guidodehek/InterfaceS88GleisboxRPi/README.md

# InterfaceS88GleisboxRPi
Interface pcb for controlling Märklin model railway using the Gleisbox (60116) and S88 via Rocrail.
