guidodehek/InterfaceS88GleisboxRPi/documentation/MoBa-PI – Stephans Homepage.pdf

## Modellbahn, Motorrad und dann mal sehen…

# Stephans Homepage (https://s-hoppe.de/)

Seitennavigation

Home (https://s-hoppe.de/)
Modellbahn (https://s-hoppe.de/modellbahn/)
Warum Spur
N? (https://s-hoppe.de/modellbahn/warum-spur-n/)
Modellbahn
Digitalsteuerung (https://s-hoppe.de/modellbahn/digital/)
Welche
Digitalzentrale
ist die beste? (https://s-hoppe.de/welche-digitalzentrale-ist-die-beste/)

Rückmeldung (https://s-hoppe.de/modellbahn/digital/rueckmeldung/)
Stromfühler (https://s-hoppe.de/modellbahn/digital/stromfuehler/)
MoBa-PI (https://s-hoppe.de/modellbahn/digital/moba-pi/)
MoBa-Pi
Hardware (https://s-hoppe.de/modellbahn/digital/moba-pi/moba-pi-hardware/)
MoBa-Pi3
Hardware (https://s-hoppe.de/modellbahn/digital/moba-pi3-hardware/)
MoBa-Pi
Software (https://s-hoppe.de/modellbahn/digital/moba-pi/moba-pi-software/)
MoBa-Pi
Software
Quick
Guide (https://s-hoppe.de/modellbahn/digital/moba-pi/moba-pi-software-quick-guide/)

Modellbahn
Versuchsanlage (https://s-hoppe.de/modellbahn-versuchsanlage/)

# MoBa-PI

Der MoBa-Pi ist keine Erfindung von mir. Im Internet finden sich Bauanleitungen um den Raspberry Pi (https://www.raspberrypi.org/) mit SRCPD (simpe railroad commmand protocol deamon) (https://sourceforge.net/projects/srcpd/files/srcpd/) und Rocrail (http://wiki.rocrail.net/doku.php?id=start-de) zu betreiben.

Insbesondere diese Seite von Stephan Richter sollte man unbedingt lesen:

http://www.pcwelt.de/ratgeber/Modellbahnsteuerung_mit_dem_Raspberry_Pi-Guenstig_selber_machen-8937533.html (http://www.pcwelt.de/ratgeber/Modellbahnsteuerung_mit_dem_Raspberry_Pi-Guenstig_selber_machen-8937533.html)

Gegenüber einer „normalen“ Zentrale hat das Ganze den Nachteil, dass es immer etwas umständlich ist, denn man hat mindestens den Raspberry Pi (https://www.raspberrypi.org/) und einen Booster und jeweils ein Netzteil. Doch es geht praktischer mit „MoBa-Pi“! Ein weiterer Vorteil ist, dass Rocrail (http://wiki.rocrail.net/doku.php?id=start-de) auch noch auf dem Raspberry Pi (https://www.raspberrypi.org/) laufen kann und somit mit einem „Kästchen“ alles erledigt ist (es gibt einige Einschränkungen, dazu später mehr).

MoBa-Pi3 beschreibt die Verwendung des Rasperry Pi 2 oder 3. Da diese beiden Raspberrys eine 40 Polige Schnittstelle bieten, für die viele noch Kabel haben werden, da sie der alten IDE Fesplattenschinttstelle im PC entspricht, habe ich hier ein anderes Konzept

Home (https://s-hoppe.de/) | Modellbahn (https://s-hoppe.de/modellbahn/) | Motorrad fahren (https://s-hoppe.de/motorrad/) | Stephans Blog (https://s-hoppe.de/category/stephans-blog/)
Podcasts und Links (https://s-hoppe.de/podcasts-und-links/) | Über mich (https://s-hoppe.de/ueber-mich/) | Kontakt (https://s-hoppe.de/kontakt/)

Impressum, Haftungsausschluss und Datenschutzerklärung (https://s-hoppe.de/impressum-und-haftungsauschluss/)

Aufbau der
Versuchsanlag
e (https://s-hoppe.de/modellbahn-versuchsanlage/aufbau-der-versuchsanlage/)
neue
Modellbahn
Versuchsanlag
e (https://s-hoppe.de/modellbahn-versuchsanlage/versuchsanlage-neu/)

Motorrad fahren (https://s-hoppe.de/motorrad/)
Wie ich zu
meiner XJ 600 N
gekommen bin (https://s-hoppe.de/motorrad/wie-ich-zu-meiner-xj-600-n-gekommen-bin/)
Wie ich das
Motorrad auf den
ersten Winter
vorbereitet habe (https://s-hoppe.de/motorrad/wie-ich-das-motorrad-auf-den-ersten-winter-vorbereitet-habe/)
Was mir gut
geholfen hat (https://s-hoppe.de/motorrad/was-mir-gut-geholfen-hat/)
Ein Motorrad,
das mir wie
angegossen
passt! (https://s-hoppe.de/motorrad/ein-motorrad-das-mir-wie-angegossen-passt/)
Stephans Blog (https://s-hoppe.de/category/stephans-blog/)
Podcasts und
Links (https://s-hoppe.de/podcasts-und-links/)
Mein eigener
Podcast (https://s-hoppe.de/mein-eigener-podcast/)
Über mich (https://s-hoppe.de/ueber-mich/)
Kontakt (https://s-hoppe.de/kontakt/)
Impressum,
Haftungsausschlus
s und
Datenschutzerkläru
ng (https://s-hoppe.de/impressum-und-haftungsauschluss/)

umgesetzt. Ich verzichte darauf so ziemlich alles in eine Box zu packen und habe dafür ein einfach zu verwendendes und trotzdem schnell einsatzbereites System. Die verwendete SW unterscheidet sich nicht.

Um eine einfache, schnell einsatzbereite Digitalsteuerung zu haben hatte ich mir eine ROCO (http://www.roco.cc/de/home/index.html) Lokmaus 2 gekauft. Die ist aber vom Funktionsumfang her doch sehr eingeschränkt (keine langen Adressen, wenig Funktionen). Deshalb kam noch eine Multimaus (http://www.roco.cc/de/product/5215-0-0-0-0-0-0-004001/products.html) dazu (diesmal von Fleischmann, ist aber 100% die ROCO (http://www.roco.cc/de/home/index.html) Multimaus). (http://www.roco.cc/de/product/5215-0-0-0-0-0-0-004001/products.html) Da die Multimaus (http://www.roco.cc/de/product/5215-0-0-0-0-0-0-004001/products.html) bei einigen Versendern und bei Ebay (http://www.ebay.de/sch/i.html?_odkw=mutli+maus&_osacat=0&_from=R40&_nkw=multimaus&_sacat=0) als Komplettset mit Booster (Gleisbox) billiger ist als solo hatte ich nun den zweiten Booster übrig. Die Booster (http://www.ebay.de/sch/i.html?_nkw=Roco+10764&_sop=1) lassen sich aber auch so preiswert besorgen.

Was liegt also näher als den Raspberry Pi (https://www.raspberrypi.org/) mit dem Booster (http://www.ebay.de/sch/i.html?_nkw=Roco+10764&_sop=1) als Computerzentrale zu verwenden?

Die Arbeiten teilen sich, wie eigentlich immer, in die zwei Bereiche Hardware und Software auf. Zu jedem der Bereiche habe ich eine eigene Seite erstellt (Software ist noch nicht fertig), aber ich empfehle das Ganze parallel anzugehen.

-> MoBa-Pi Hardware (https://s-hoppe.de/modellbahn/digital/moba-pi/moba-pi-hardware/)

-> MoBa-Pi3 Hardware (https://s-hoppe.de/modellbahn/digital/moba-pi3-hardware/)

-> MoBa-Pi Software (für alle HW-Varianten gleich) (https://s-hoppe.de/modellbahn/digital/moba-pi/moba-pi-software/)

WordPress Theme: Smartline by ThemeZee.
