guidodehek/InterfaceS88GleisboxRPi/documentation/schematic/pican-01_orc_sch.pdf

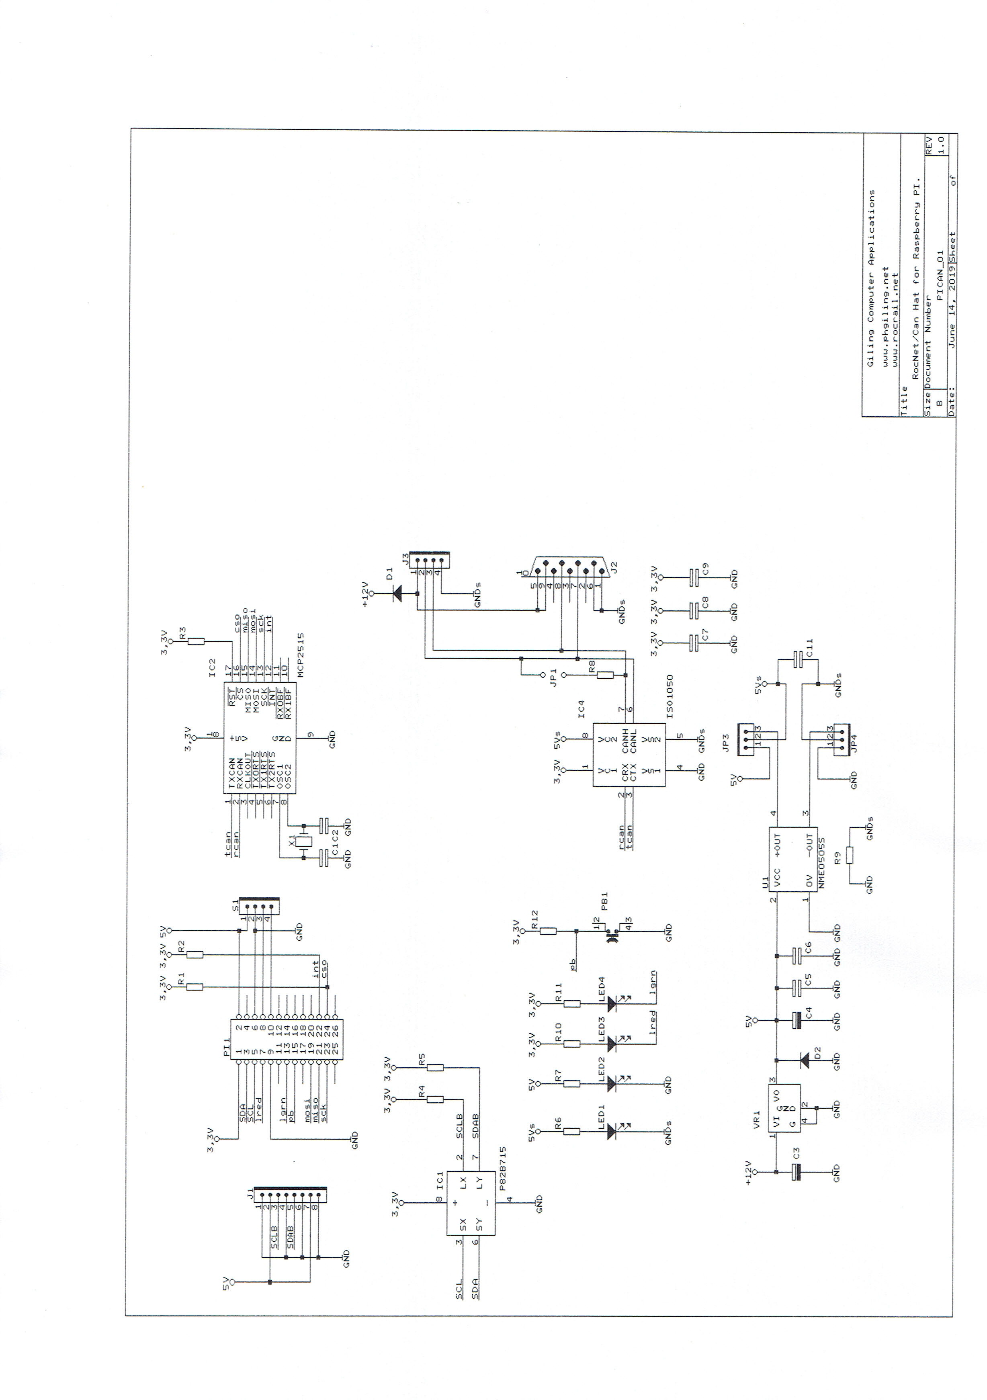
[picture p21: page 1]
