guidodehek/InterfaceS88GleisboxRPi/documentation/schematic/schematicPiGleisboxS88.png

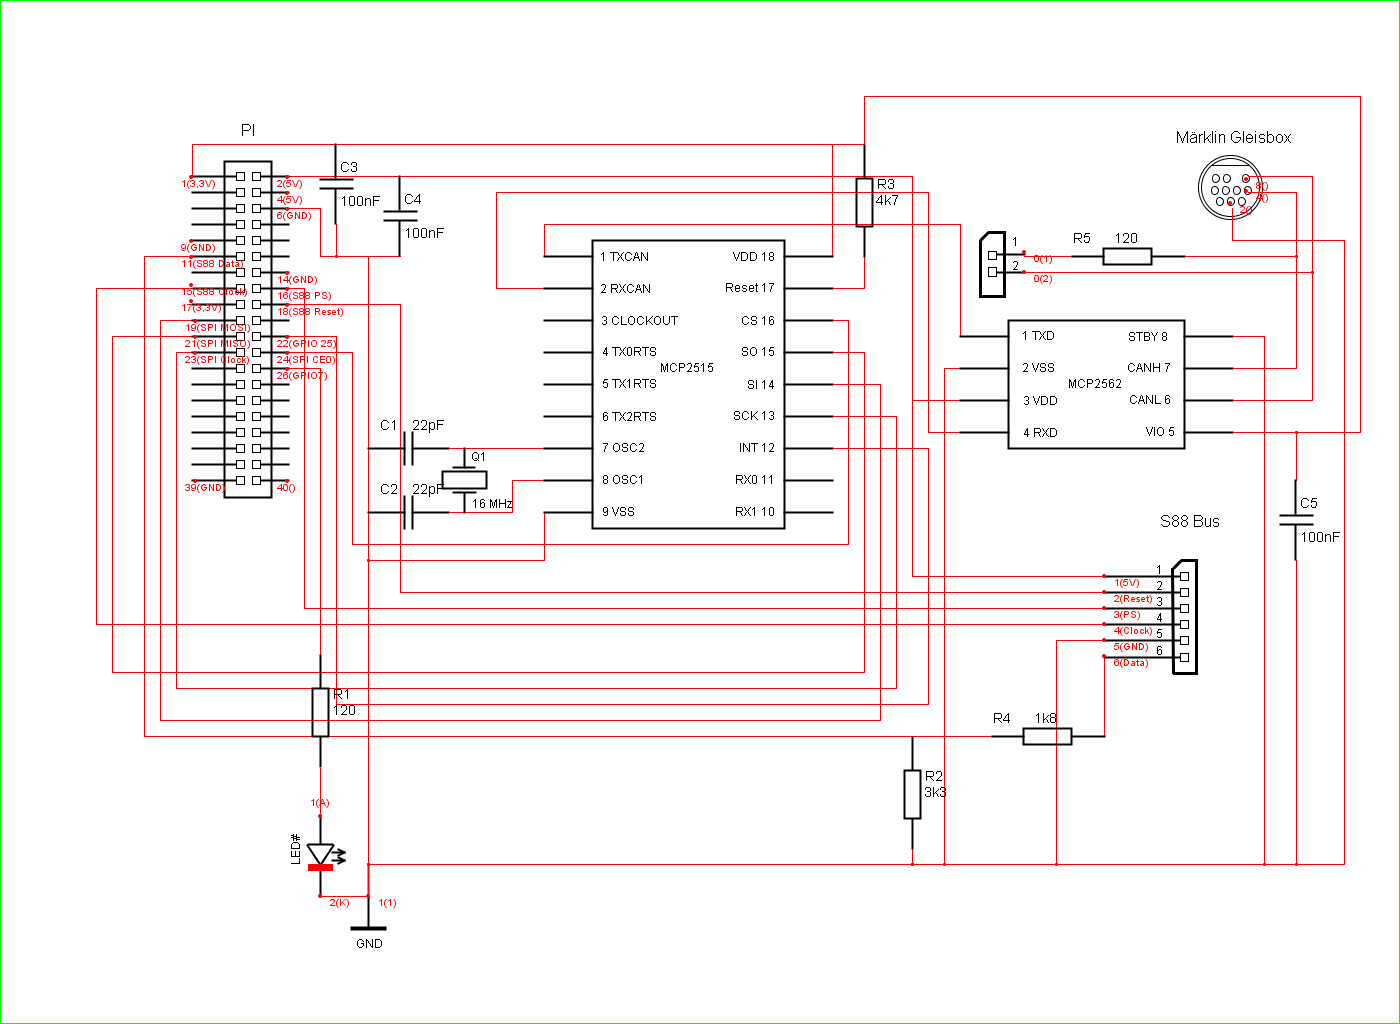
documentation/schematic/schematicPiGleisboxS88.png
