guidodehek/InterfaceS88GleisboxRPi/pcb/InterfaceS88GleisboxRPi/BillOfMaterials.xlsx

Reference | Value | Datasheet | Footprint | Qty | DNP | Available
C1,C2 | 22p | ~ | Capacitor_SMD:C_0805_2012Metric | 2 |  | 2
C3,C4,C5,C7,C8,C9,C10 | 100n | ~ | Capacitor_SMD:C_0805_2012Metric | 7 |  | 3
C6 | 10u | ~ | Capacitor_SMD:C_0805_2012Metric | 1 |  | 1
C11 | 1u | ~ | Capacitor_SMD:C_0805_2012Metric | 1 |  | 1
D1,D2 | LED | ~ | LED_SMD:LED_0603_1608Metric | 2 |  | 0
J1 | ~ |  | Connector_PinSocket_2.54mm:PinSocket_2x20_P2.54mm_Vertical | 1 |  | 0
J2 | KMDGX-10S-BS |  | CustomLib:KMDGX10SBS | 1 |  | 0
J4 | RJ45 | ~ | CustomLib:215877-1 | 1 |  | 0
J7 | PJ-102AH | ~ | Connector_BarrelJack:BarrelJack_CUI_PJ-102AH_Horizontal | 1 |  | 0
R1 | 120 | ~ | Resistor_SMD:R_0805_2012Metric | 1 |  | 0
R2,R3,R4 | 4k7 | ~ | Resistor_SMD:R_0805_2012Metric | 3 |  | 3
R5 | 330 | ~ | Resistor_SMD:R_0805_2012Metric | 1 |  | 1
R6 | 390 | ~ | Resistor_SMD:R_0805_2012Metric | 1 |  | 1
R7,R11,R13 | 270 | ~ | Resistor_SMD:R_0805_2012Metric | 3 |  | 0
R8,R12,R14 | 1k5 | ~ | Resistor_SMD:R_0805_2012Metric | 3 |  | 3
R9 | 680 | ~ | Resistor_SMD:R_0805_2012Metric | 1 |  | 1
R10 | 220 | ~ | Resistor_SMD:R_0805_2012Metric | 1 |  | 1
R15,R16 | 1k | ~ | Resistor_SMD:R_0805_2012Metric | 2 |  | 0
R17 | 0 | ~ | Resistor_SMD:R_0805_2012Metric | 1 |  | 0
SW1 | SW_Push | ~ | Button_Switch_THT:SW_PUSH_6mm | 1 |  | 0
U1 | MCP2515-xSO | http://ww1.microchip.com/downloads/en/DeviceDoc/21801e.pdf | Package_SO:SOIC-18W_7.5x11.6mm_P1.27mm | 1 |  | 1
U2 | ISO1050DUB | http://www.ti.com/lit/ds/symlink/iso1050.pdf | Package_SO:SOP-8_6.62x9.15mm_P2.54mm | 1 |  | 0
U3 | NME0505SC | https://power.murata.com/datasheet?/data/power/ncl/kdc_nme.pdf | CustomLib:Murata-NME0505SC-0-0-0 | 1 |  | 0
U4 | LM317_SOT-223 | http://www.ti.com/lit/ds/symlink/lm317.pdf | Package_TO_SOT_SMD:SOT-223-3_TabPin2 | 1 |  | 0
U5,U6,U7,U8 | 6N137 | https://docs.broadcom.com/docs/AV02-0940EN | Package_DIP:DIP-8_W7.62mm | 4 |  | 0
Y1 | 16Mhz | ~ | Crystal:Crystal_HC50_Vertical | 1 |  | 0
