guidodehek/InterfaceS88GleisboxRPi/pcb/InterfaceS88GleisboxRPi/KicadLib/IC_Murata_NME0505SC/eec.models/Murata_-_NME0505SC.step

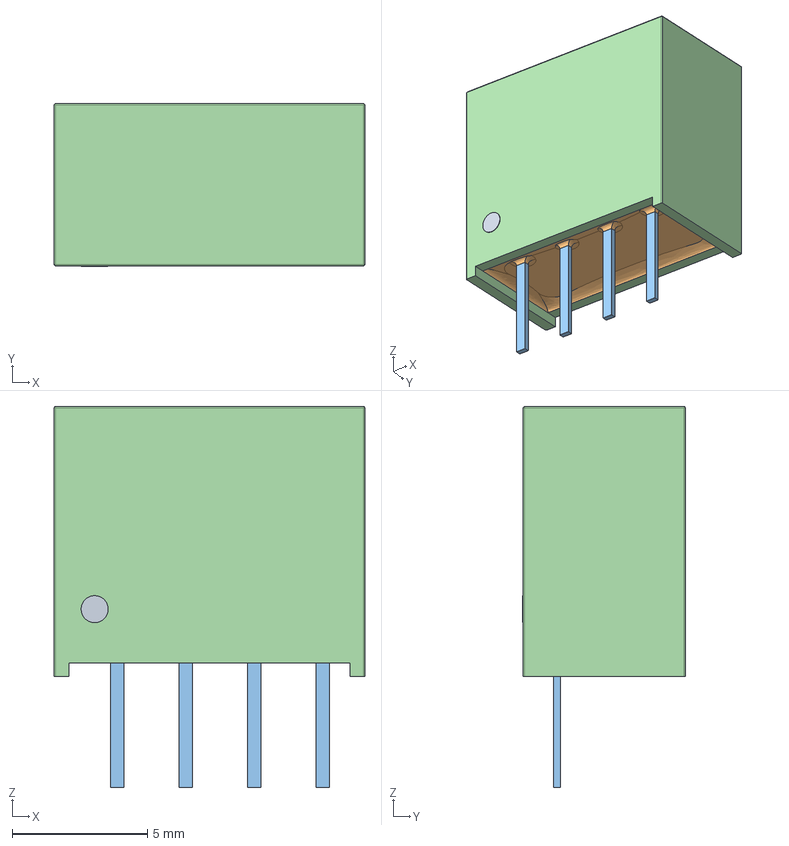
[picture p23: CAD file, 2023-01-06]
pcb/InterfaceS88GleisboxRPi/KicadLib/IC_Murata_NME0505SC/eec.models/Murata_-_NME0505SC.step
11.5 x 6.02 x 14.1 mm
