guidodehek/InterfaceS88GleisboxRPi/manual/content/pcbdescription.tex

\section{PCB Description}

\begin{figure}[h!]
	\centering
	
	\caption{Schematic of the system.}
	\label{fig:pcbschematic}
\end{figure}
