guidodehek/InterfaceS88GleisboxRPi/manual/content/introduction.tex

\section*{Credits}
Parts of this system have been developed by members of the model railway community. This is mainly applicable for the s88udp conversion, as well as srcpd. Many thanks and full credits to them!

\newpage

\section{Introduction}
System for controlling a marklin track using a Raspberry Pi. A custom shield has been added to provide a hardware interface between the Gleisbox and the Raspberry Pi. PiCANS88 is used to provide communication between the Gleisbox and Rocrail. Rocrail is used as the control software to control the model railway. A S88N interface is also present to allow feedback of train positions to Rocrail.
