guidodehek/InterfaceS88GleisboxRPi/manual/content/s88ninterfacesetup.tex

\section{Setup of S88N-interface}
The S88N interface is used to obtain data about occupied track sections. This interface is based on 5Vdc (according to the standard 12Vdc is also possible).

\subsection{Connection Scheme}
%https://www.floodland.nl/aim/info_s88_kabels_en_1.htm
Table~\ref*{tab:S88Npinning} shows the S88N pin definitions as well as the UTP cable colors.

\begin{table}[h]
	\caption{S88N pinout and description.}
	\label{tab:S88Npinning}
	\begin{tabular}{|l|l|l|}
		\hline
		\rowcolor[HTML]{9B9B9B} 
		\textbf{RJ45 pin} & \textbf{Colour in UTP cable} & \textbf{S88N Description}             \\ \hline
		1                 & Orange-white                 & +5V (+12V not in this board)          \\ \hline
		2                 & Orange                       & Data                                  \\ \hline
		3                 & Green-white                  & GND                                   \\ \hline
		4                 & Blue                         & Clock                                 \\ \hline
		5                 & Blue-white                   & GND                                   \\ \hline
		6                 & Green                        & Load                                  \\ \hline
		7                 & Brown-white                  & Reset                                 \\ \hline
		8                 & Brown                        & Rail signal (not used in this design) \\ \hline
	\end{tabular}
\end{table}

\subsection{S88UDP installation}
Install the following libraries first (to prevent pcap.h compilation error):
\begin{verbatim}
	sudo apt-get install zlib1g-dev libpcap-dev	
\end{verbatim}

Download and install s88udp-rpi:

\begin{verbatim}
	cd
	
	git clone https://github.com/GBert/railroad
	
	cd railroad/can2udp/src
	
	make
\end{verbatim}

To start the interface: 

\begin{verbatim}
	sudo ./s88udp-rpi -v -f -c "17,22,23,24" -m 1
\end{verbatim}

Arguments behind option -c are the gpio ports. The amount of S88 modules is set using option -m. \\

To test if the udp ports are assigned for use by Rocrail:

\begin{verbatim}
	sudo netstat -autpn | egrep "Proto|157"
\end{verbatim}

The PID "Rocrail" should be displayed.
