guidodehek/InterfaceS88GleisboxRPi/documentation/schematic/s88np_v220.pdf

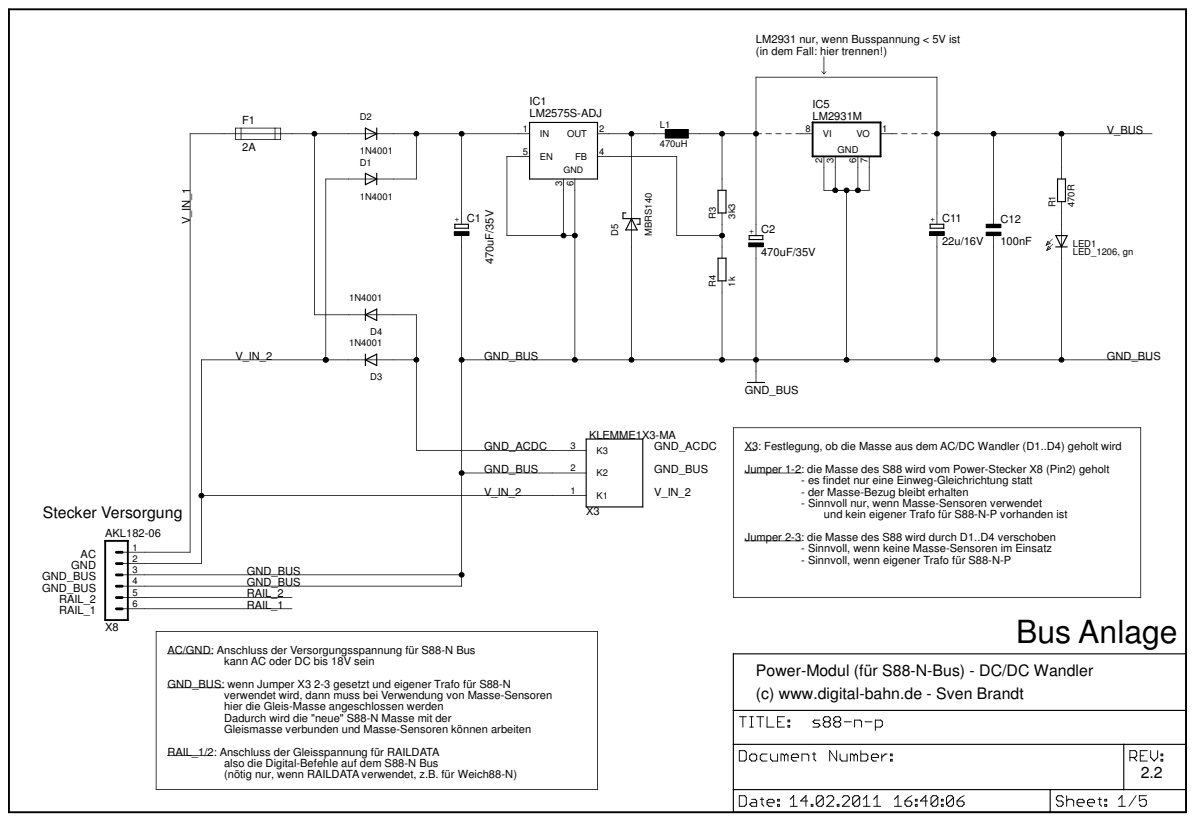
[picture p44: page 1]

LM2931 nur, wenn Busspannung < 5V ist
(in dem Fall: hier trennen!)

X3: Festlegung, ob die Masse aus dem AC/DC Wandler (D1..D4) geholt wird

Jumper 1-2: die Masse des S88 wird vom Power-Stecker X8 (Pin2) geholt

- es findet nur eine Einweg-Gleichrichtung statt
- der Masse-Bezug bleibt erhalten
- Sinnvoll nur, wenn Masse-Sensoren verwendet
und kein eigener Trafo für S88-N-P vorhanden ist

Jumper 2-3: die Masse des S88 wird durch D1..D4 verschoben

- Sinnvoll, wenn keine Masse-Sensoren im Einsatz
- Sinnvoll, wenn eigener Trafo für S88-N-P

AC/GND: Anschluss der Versorgungsspannung für S88-N Bus

kann AC oder DC bis 18V sein

Power-Modul (für S88-N-Bus) - DC/DC Wandler
(c) www.digital-bahn.de - Sven Brandt

GND_BUS: wenn Jumper X3 2-3 gesetzt und eigener Trafo für S88-N

verwendet wird, dann muss bei Verwendung von Masse-Sensoren
hier die Gleis-Masse angeschlossen werden
Dadurch wird die "neue" S88-N Masse mit der
Gleismasse verbunden und Masse-Sensoren können arbeiten

RAIL_1/2: Anschluss der Gleisspannung für RAILDATA

also die Digital-Befehle auf dem S88-N Bus
(nötig nur, wenn RAILDATA verwendet, z.B. für Weich88-N)

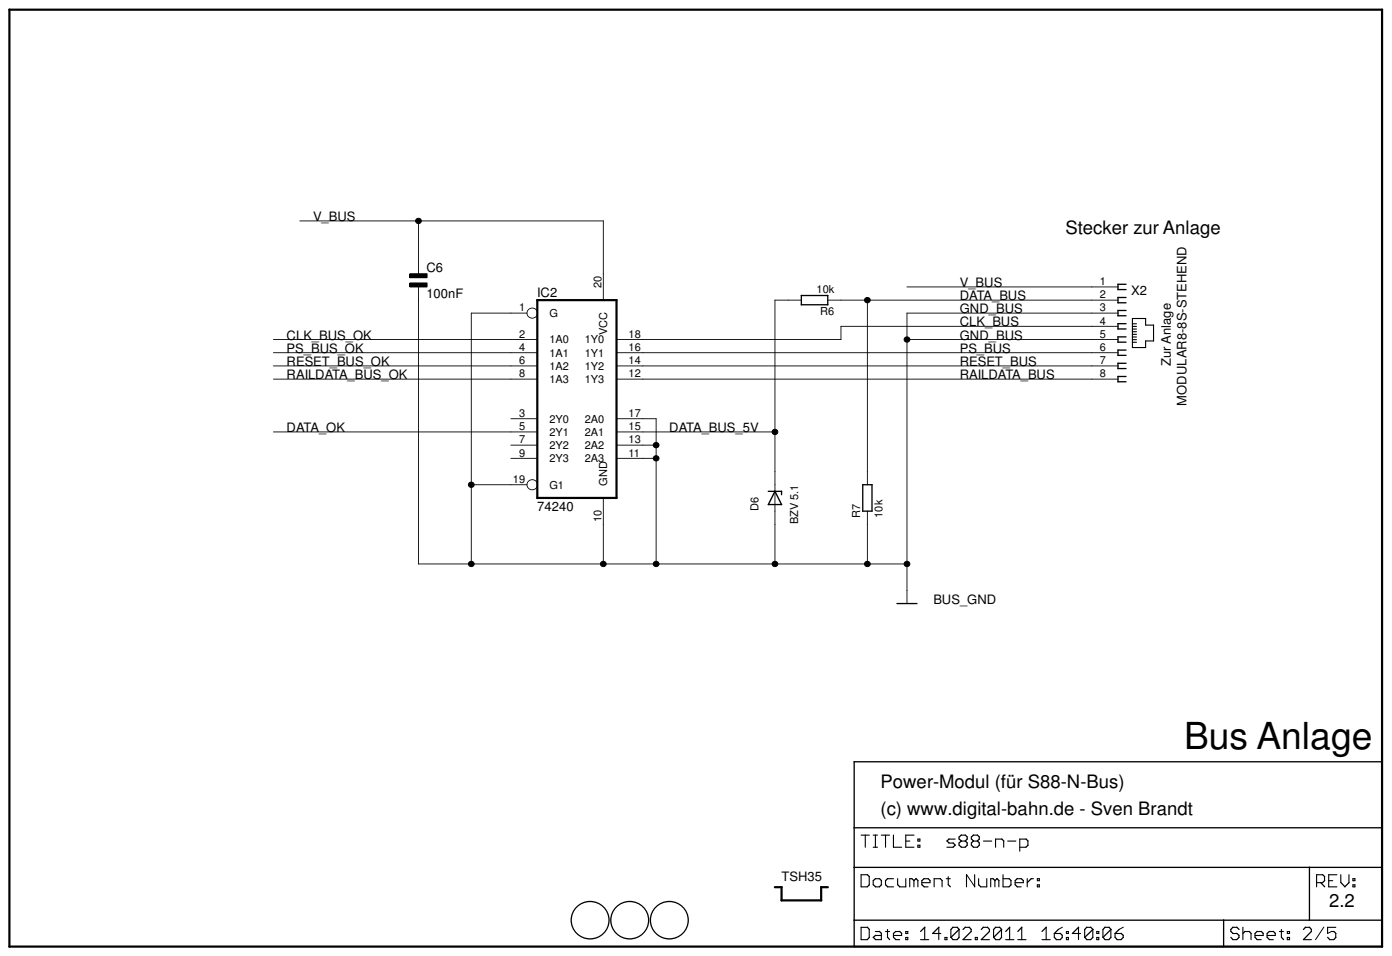
[picture p45: page 2]
BUS_GND; MODULAR8-8S-STEHEND; BZV 5.1; VCC; 20 GND; RAILDATA_BUS; GND_BUS; DATA_BUS; CLK_BUS; PS_BUS RESET_BUS; CLK_BUS_OK PS_BUS_OK RESET_BUS_OK RAILDATA_BUS_OK; DATA_OK; DATA_BUS_5V; V_BUS; TSH35; Zur Anlage; Bus Anlage

Stecker zur Anlage

Power-Modul (für S88-N-Bus)
(c) www.digital-bahn.de - Sven Brandt

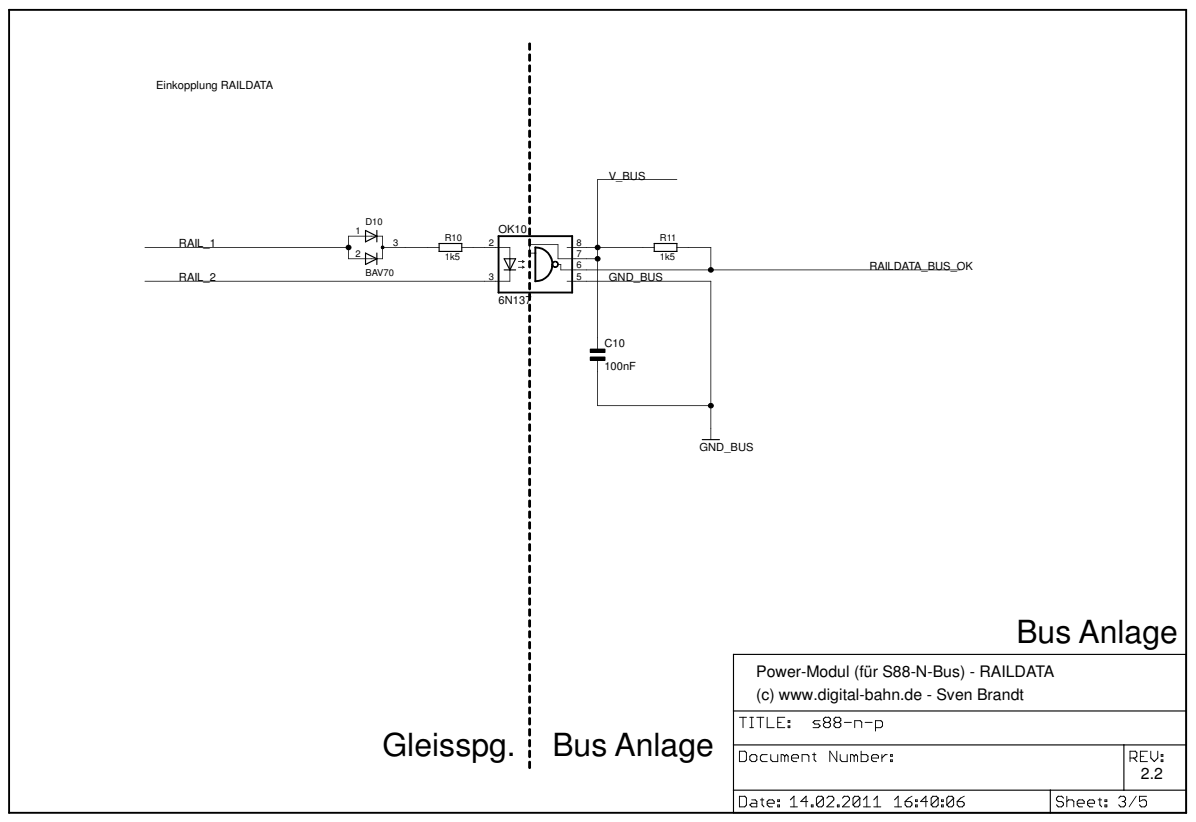
[picture p46: page 3]
BAV70; GND_BUS; RAIL_1; RAIL_2; RAILDATA_BUS_OK; V_BUS; Einkopplung RAILDATA; Bus Anlage

Power-Modul (für S88-N-Bus) - RAILDATA
(c) www.digital-bahn.de - Sven Brandt

Gleisspg. Bus Anlage

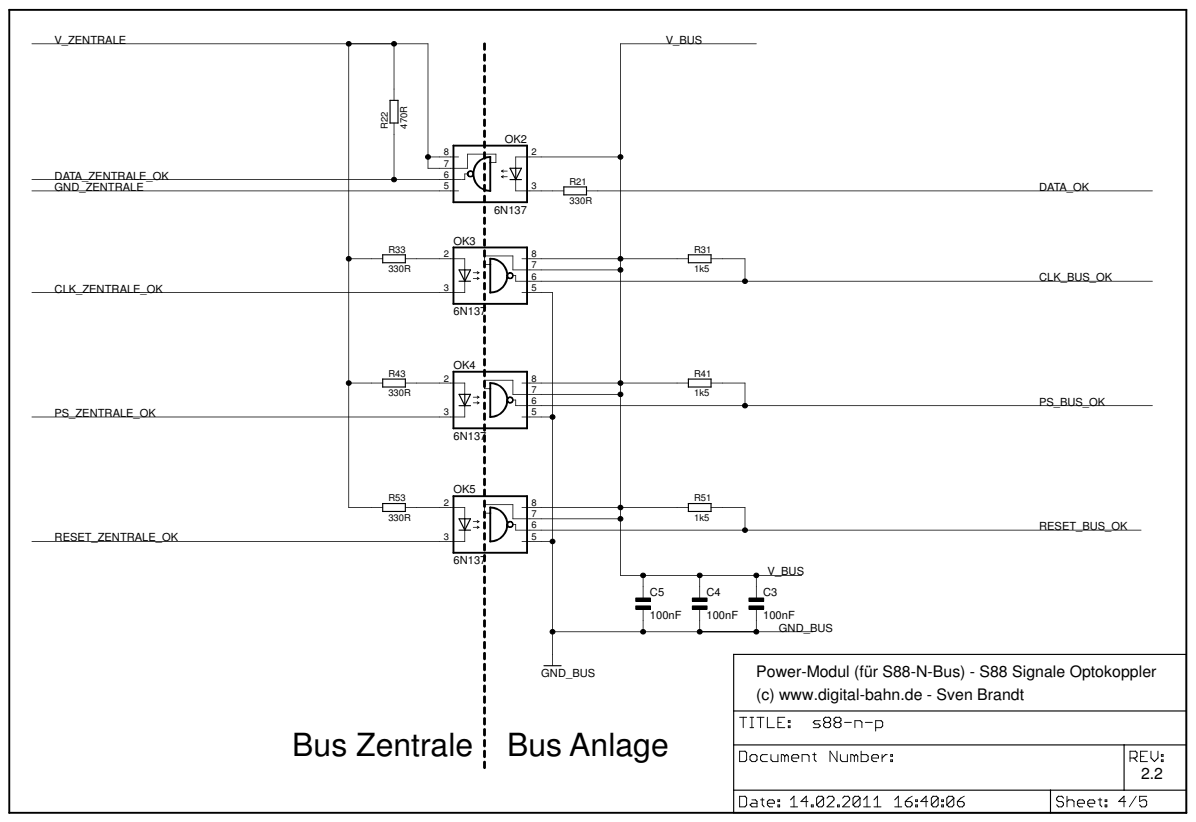
[picture p47: page 4]

Power-Modul (für S88-N-Bus) - S88 Signale Optokoppler
(c) www.digital-bahn.de - Sven Brandt

Bus Zentrale Bus Anlage

## Stecker zur Zentrale (alt)

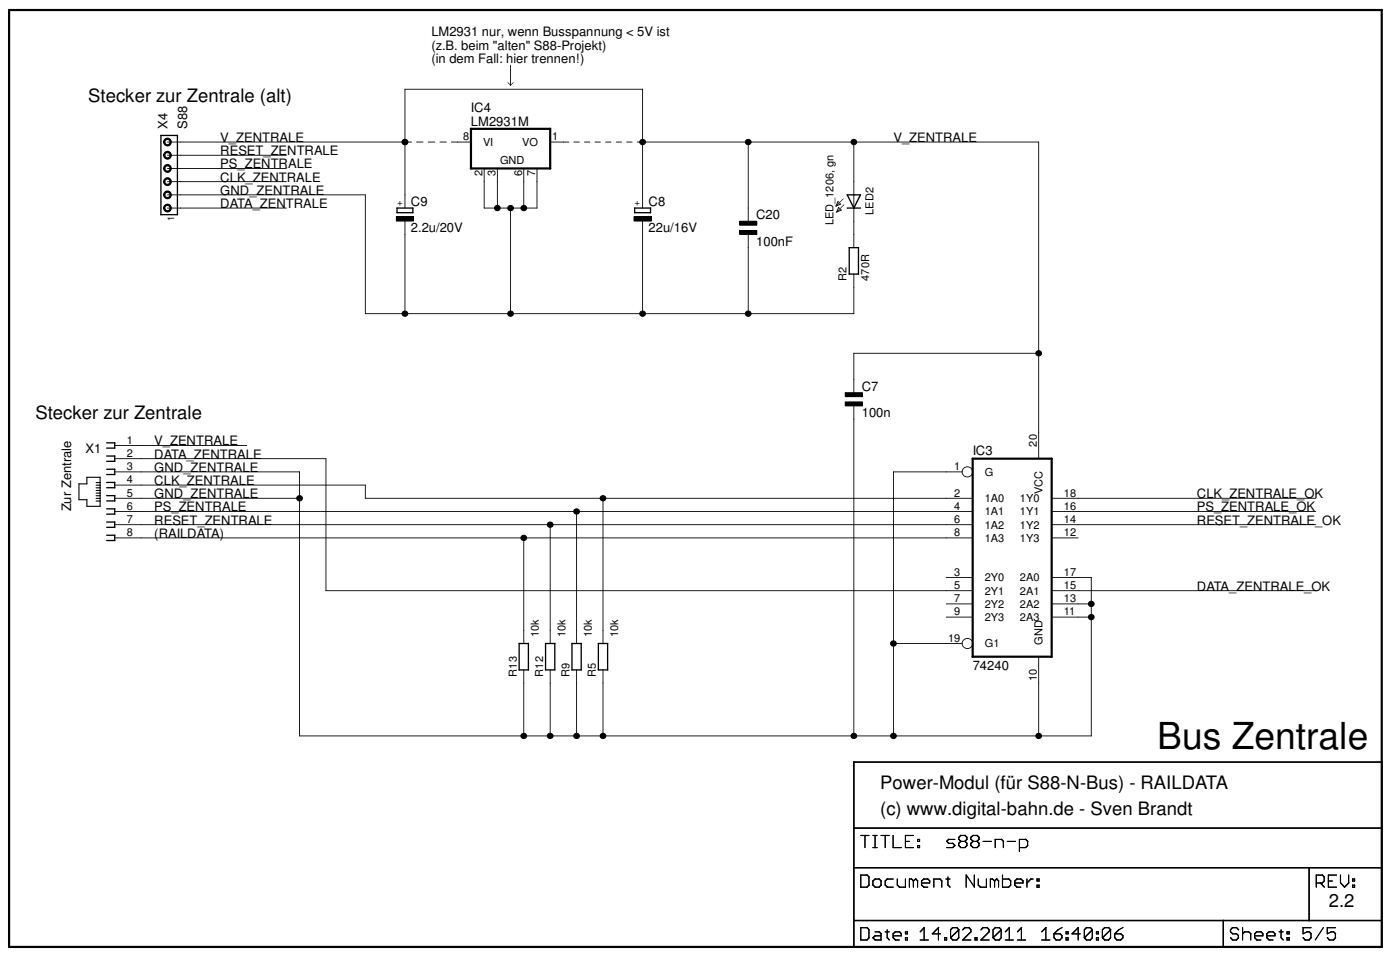
[picture p48: page 5]

LM2931 nur, wenn Busspannung < 5V ist
(z.B. beim "alten" S88-Projekt)
(in dem Fall: hier trennen!)

Power-Modul (für S88-N-Bus) - RAILDATA
(c) www.digital-bahn.de - Sven Brandt

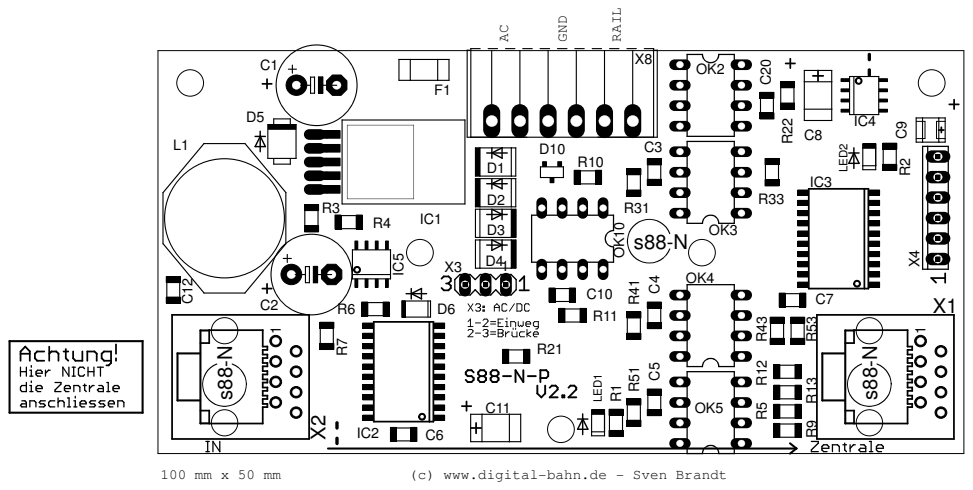
[picture p49: page 6]

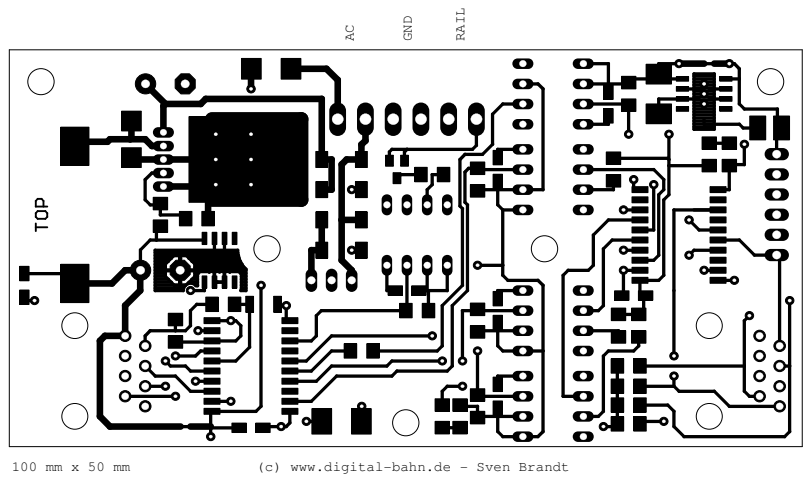
[picture p50: page 7]
(c) www.digital-bahn.de - Sven Brandt; GND; RAIL

100 mm x 50 mm | (c) www.digital-bahn.de - Sven Brandt

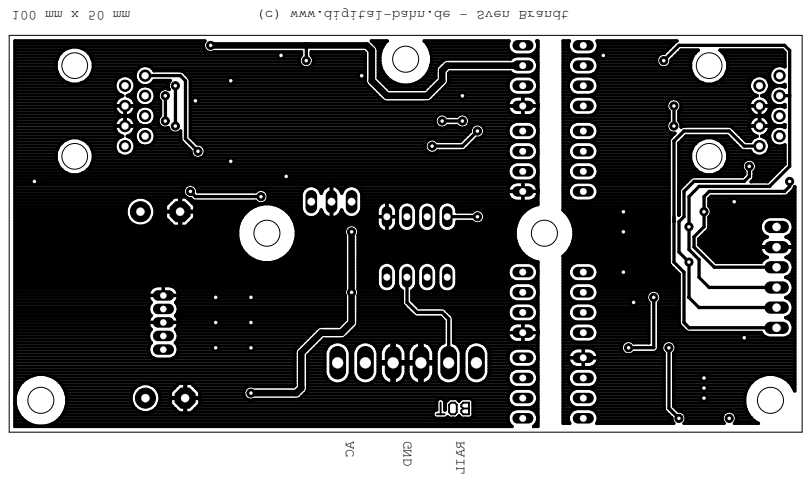
[picture p51: page 8]
GND; RAIL
