guidodehek/InterfaceS88GleisboxRPi/documentation/schematic/s88_spi_interface.pdf

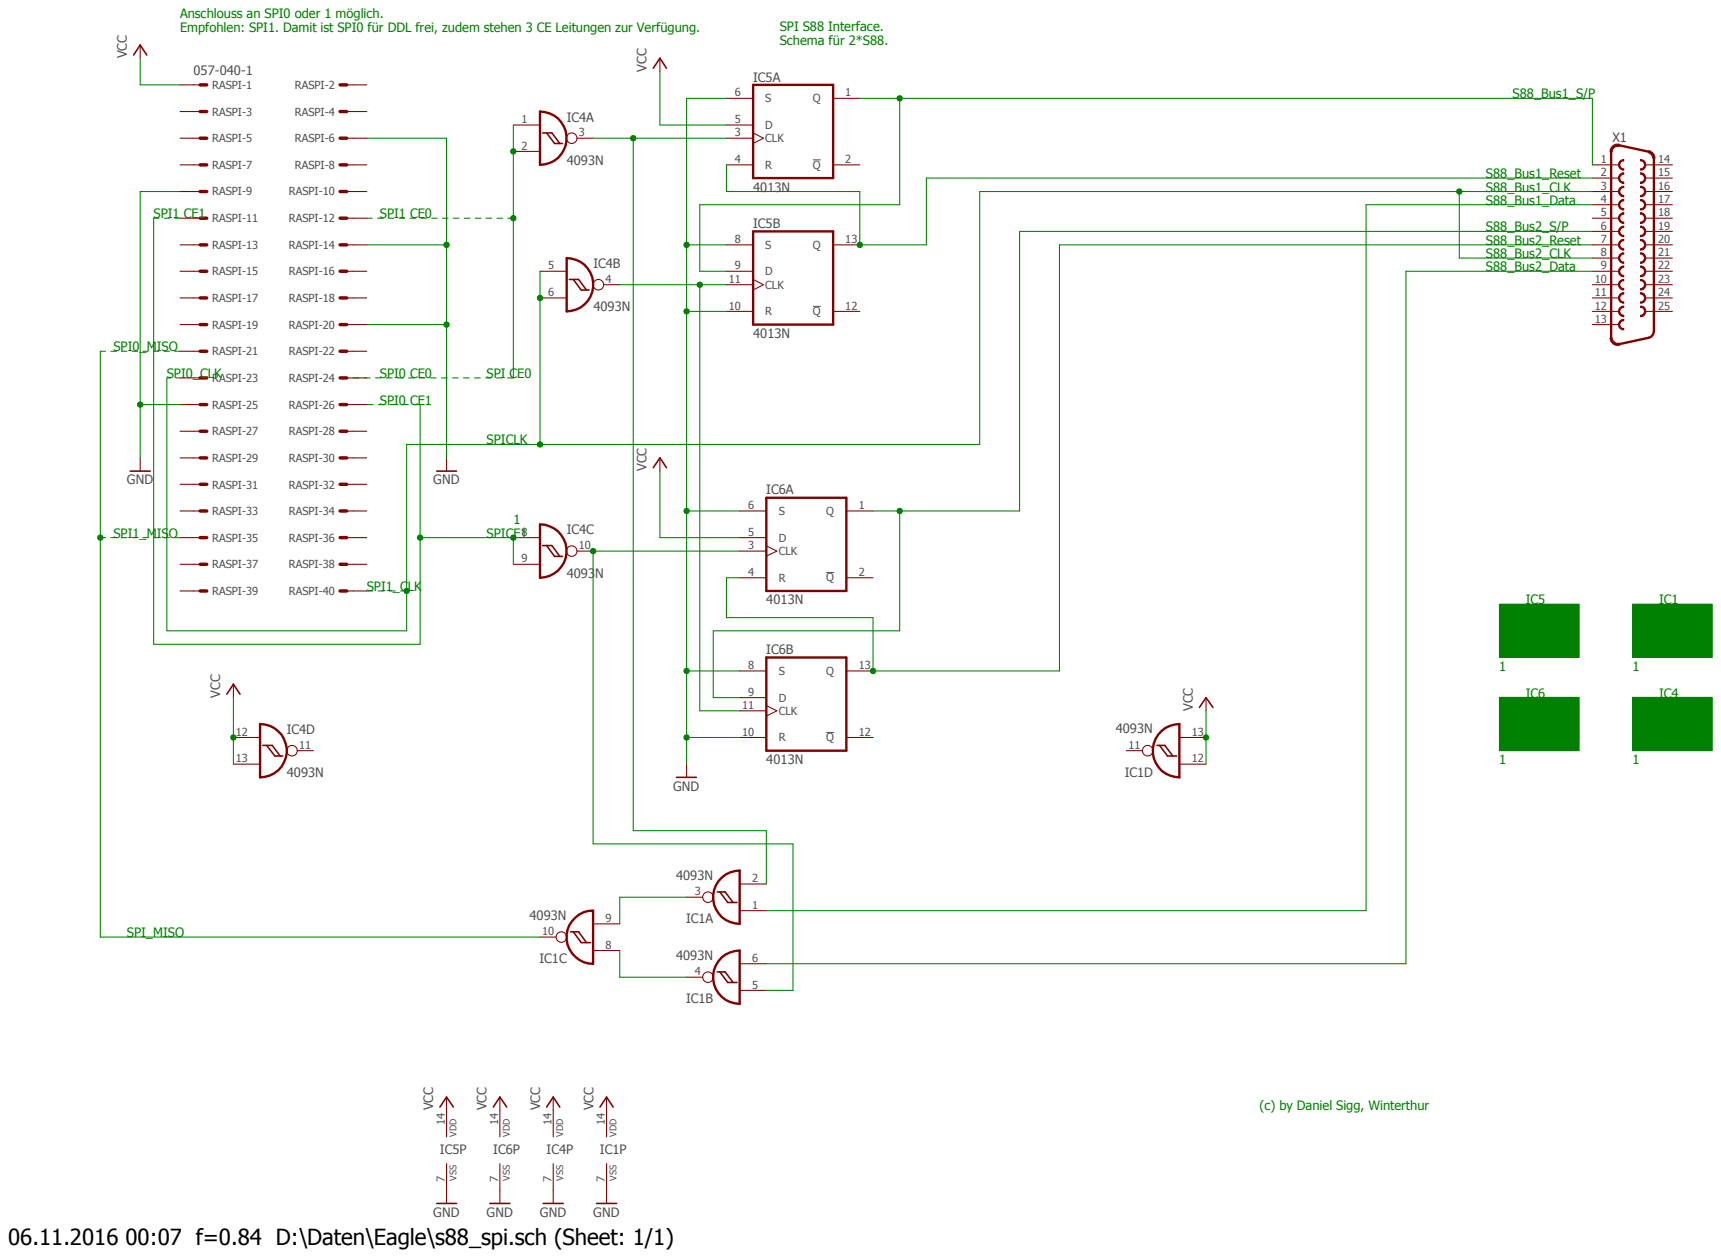
[picture p52: page 1]

Anschlouss an SPI0 oder 1 möglich.
Empfohlen: SPI1. Damit ist SPI0 für DDL frei, zudem stehen 3 CE Leitungen zur Verfügung.

(c) by Daniel Sigg, Winterthur

06.11.2016 00:07 f=0.84 D:\Daten\Eagle\s88_spi.sch (Sheet: 1/1)
