guidodehek/InterfaceS88GleisboxRPi/documentation/S88 und MBUS_Raspi4.pdf

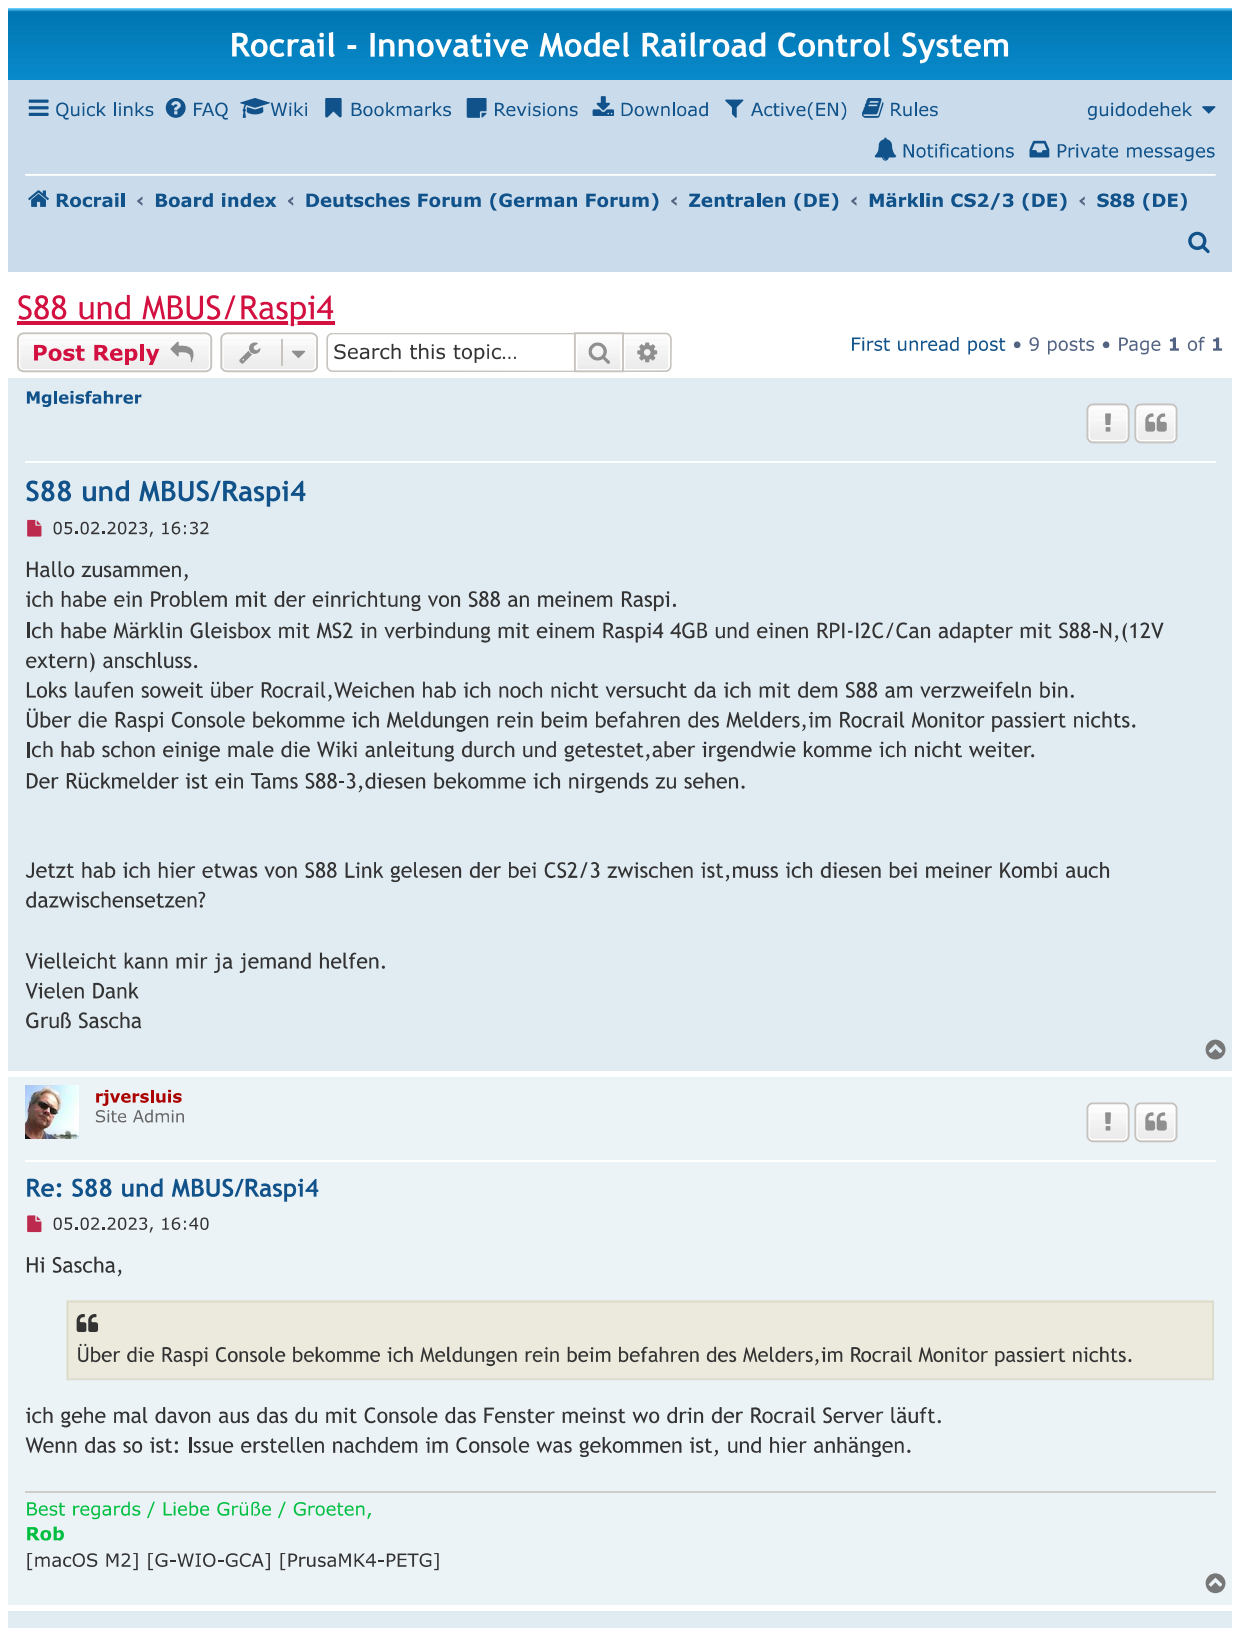
[picture p53: page 1]

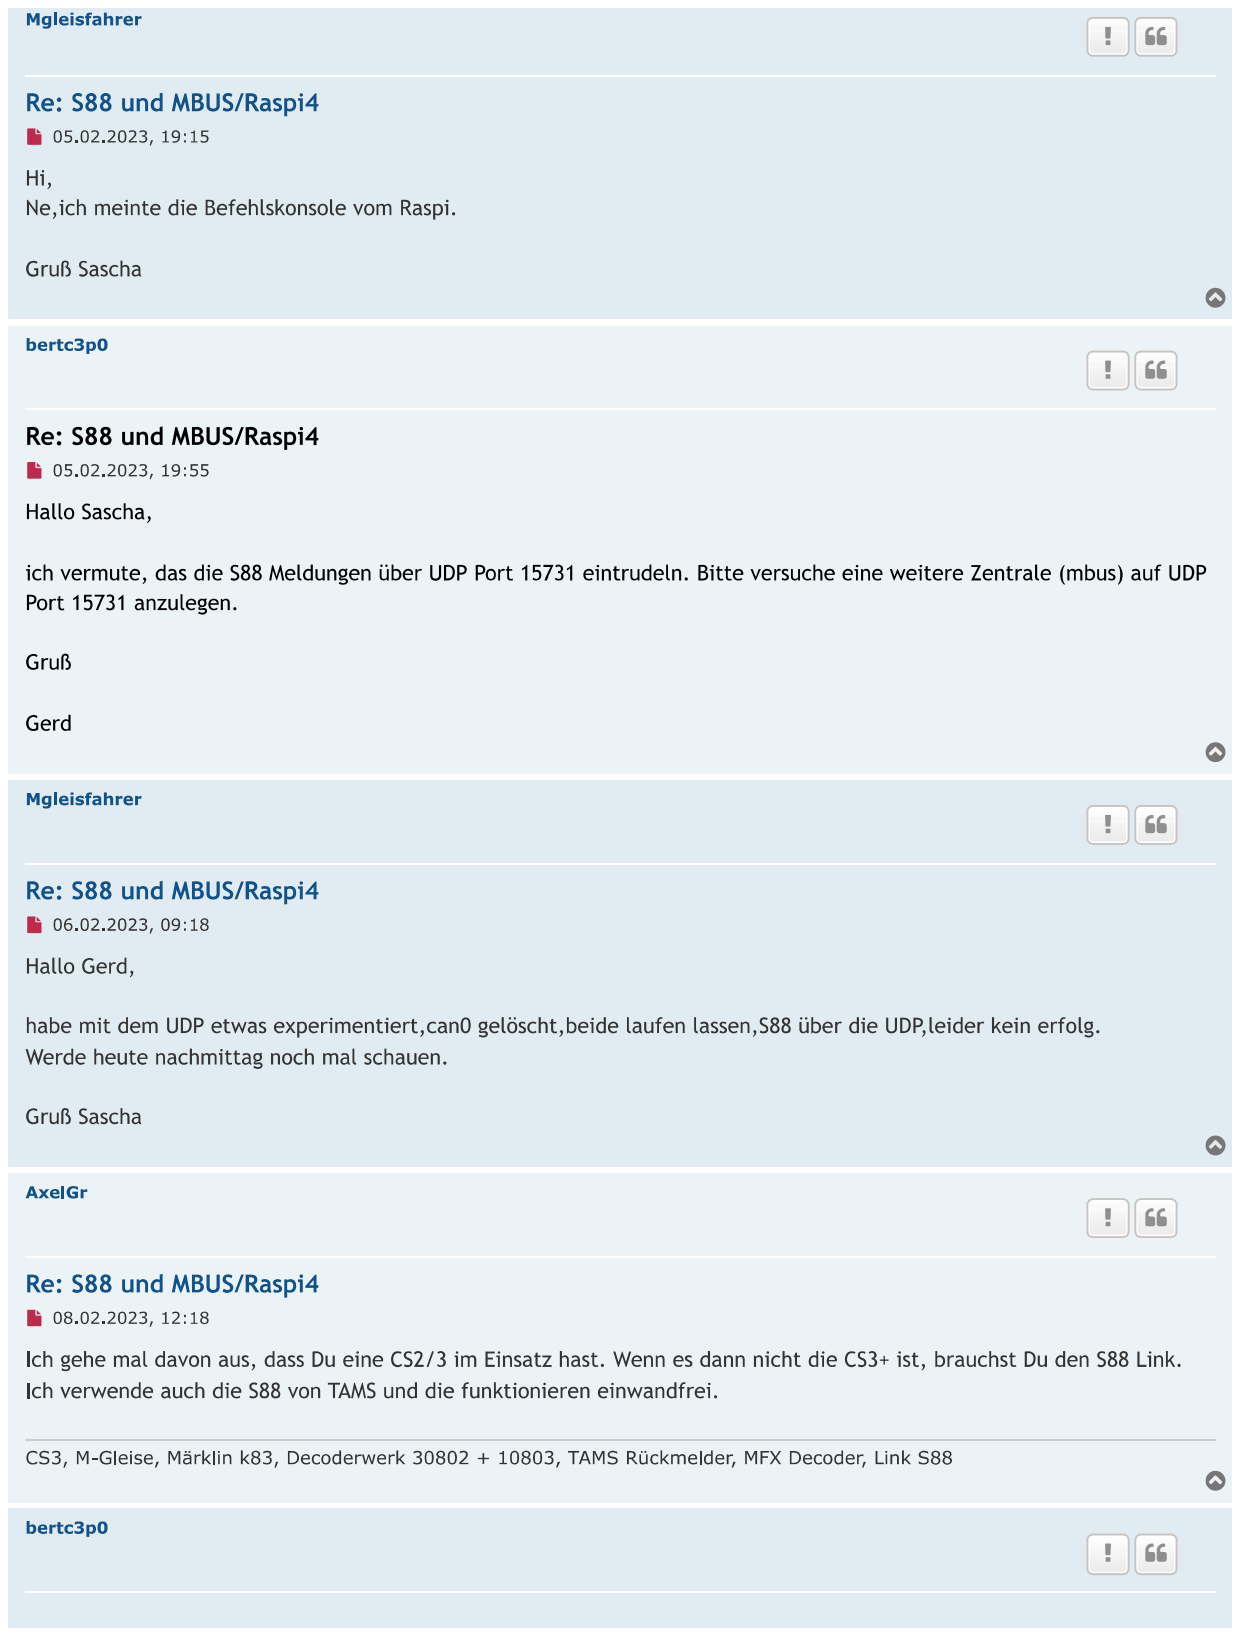
[picture p54: page 2]

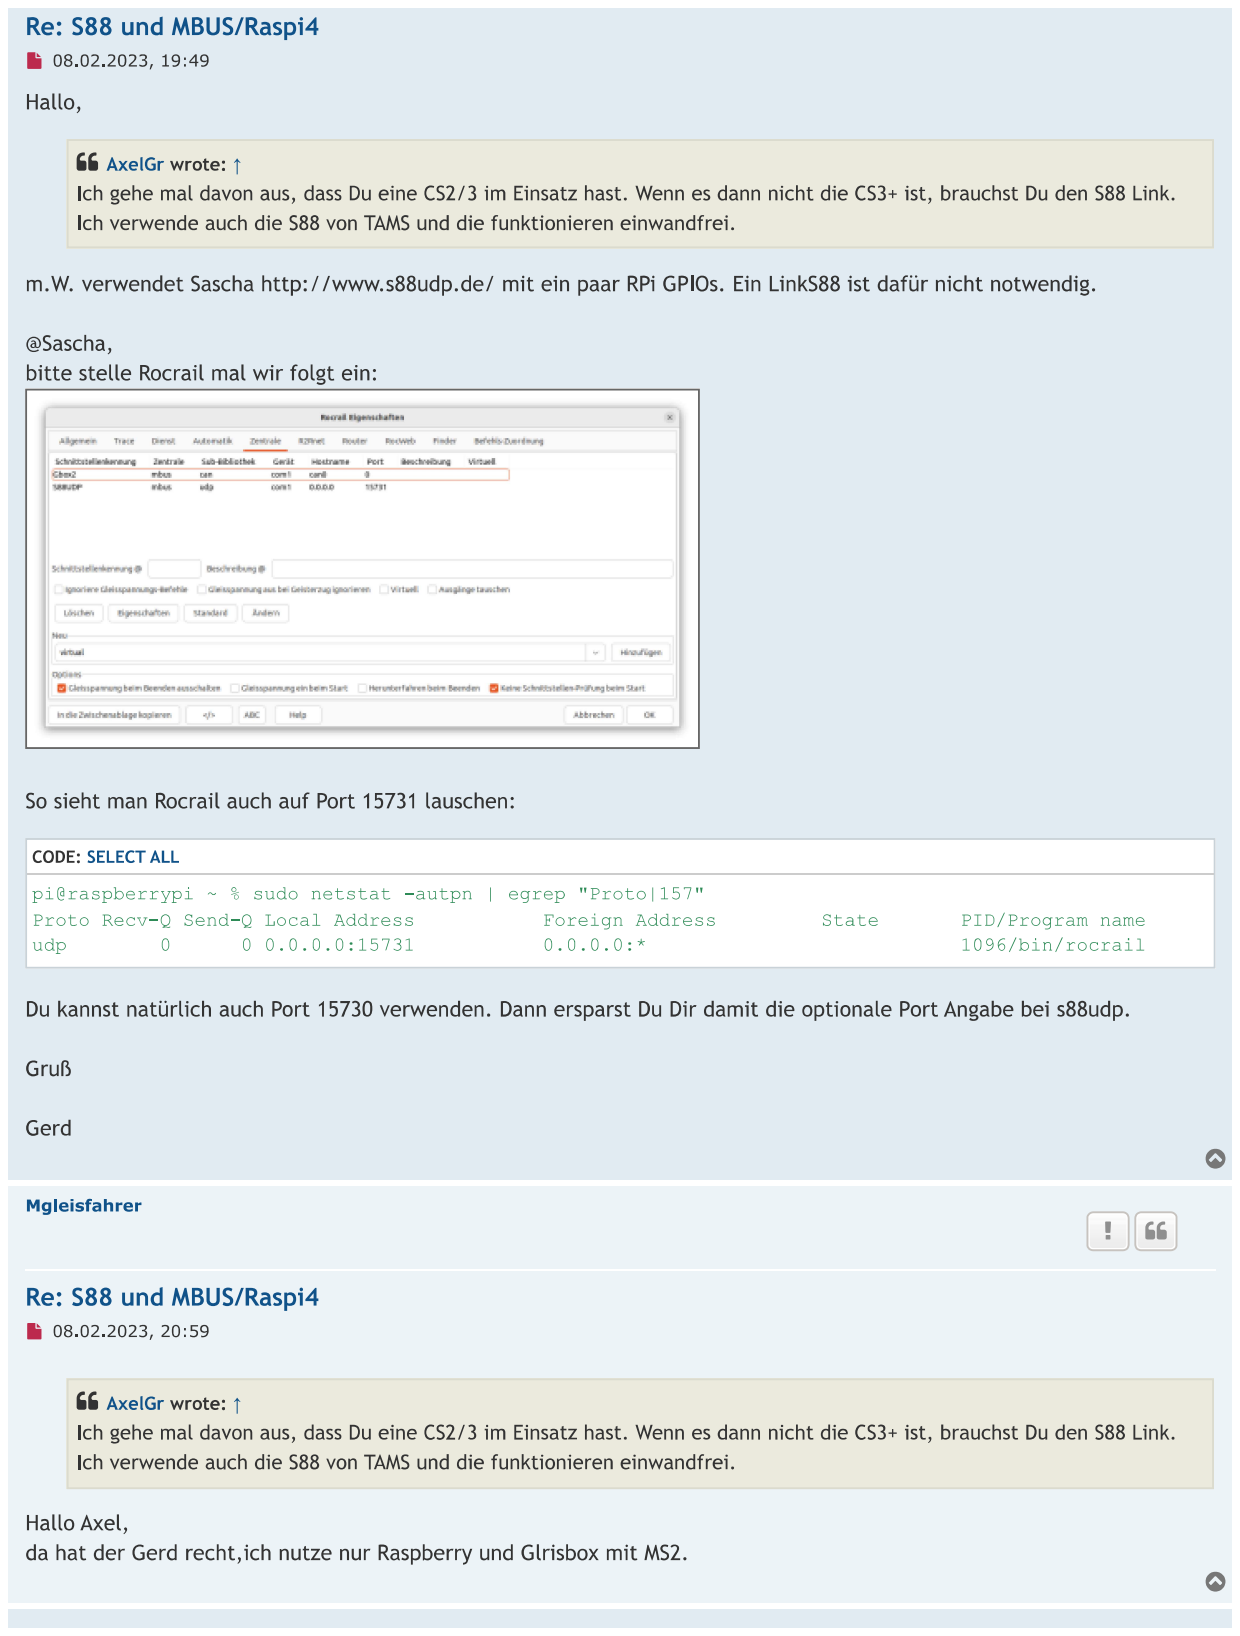
[picture p55: page 3]

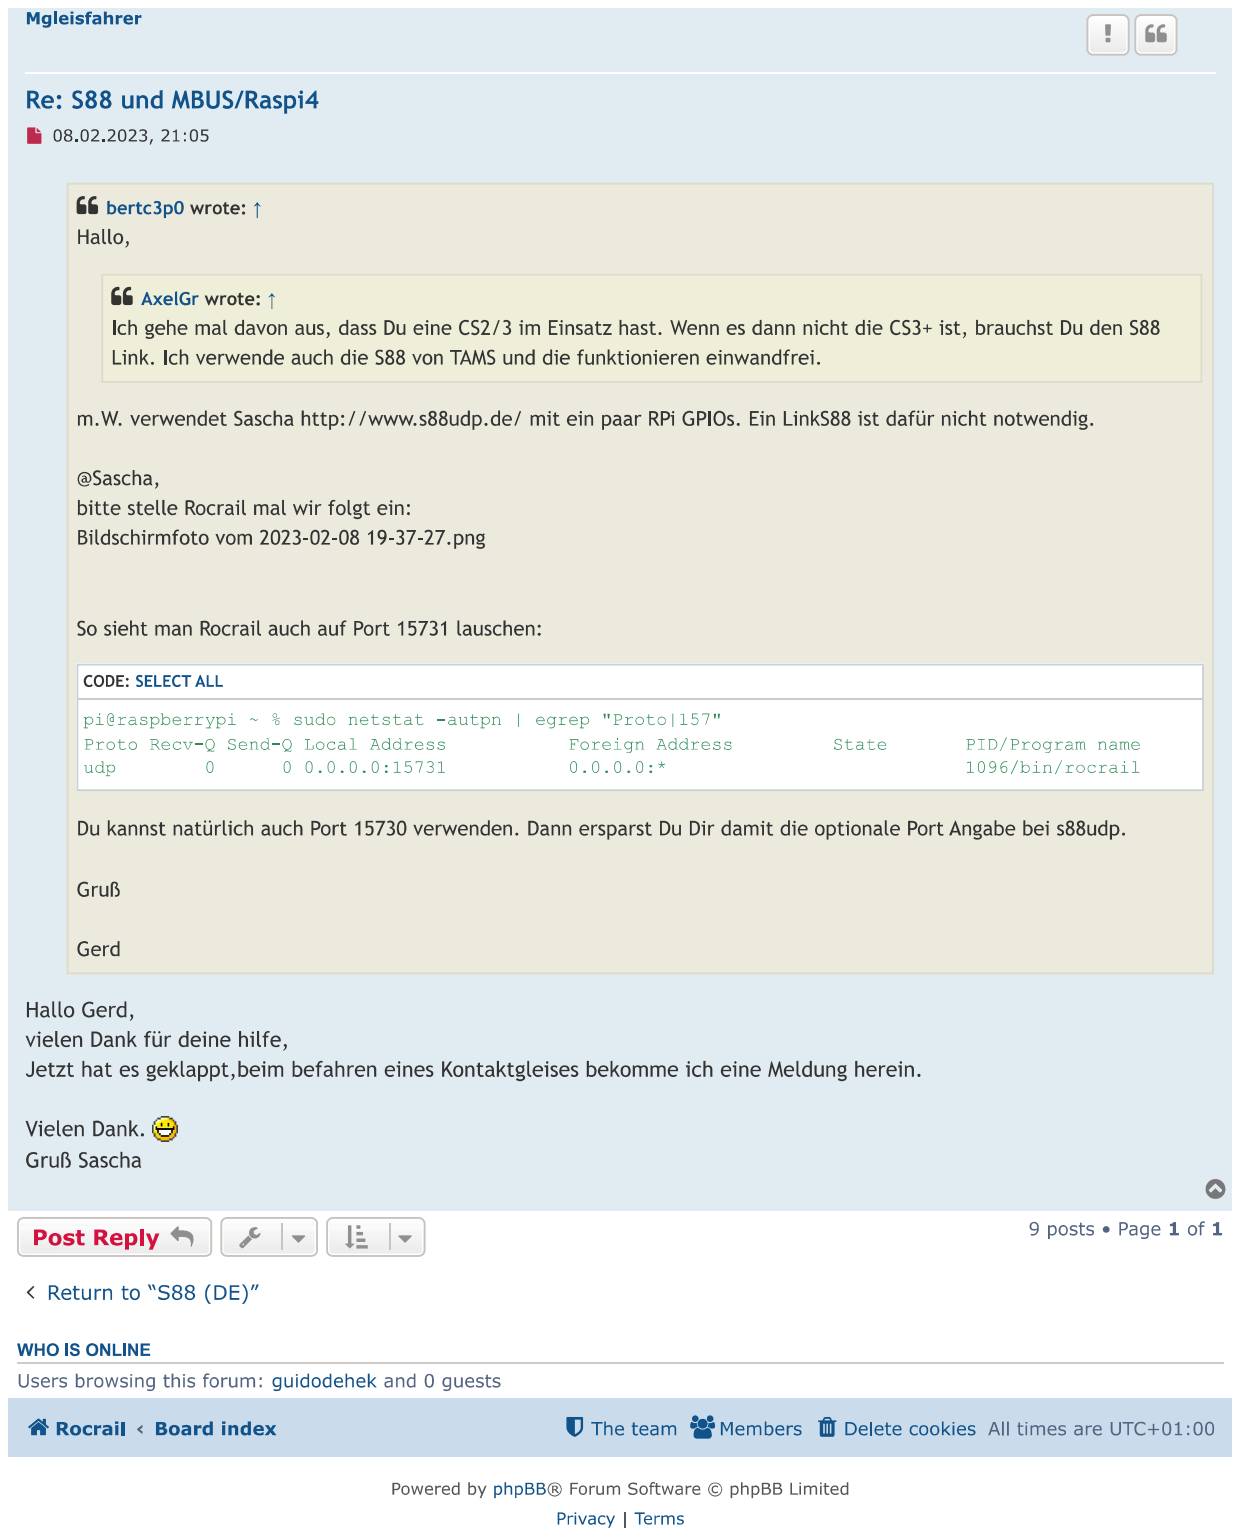
[picture p56: page 4]
