guidodehek/InterfaceS88GleisboxRPi/pcb/InterfaceS88GleisboxRPi/InterfaceS88GleisboxRPi.pdf

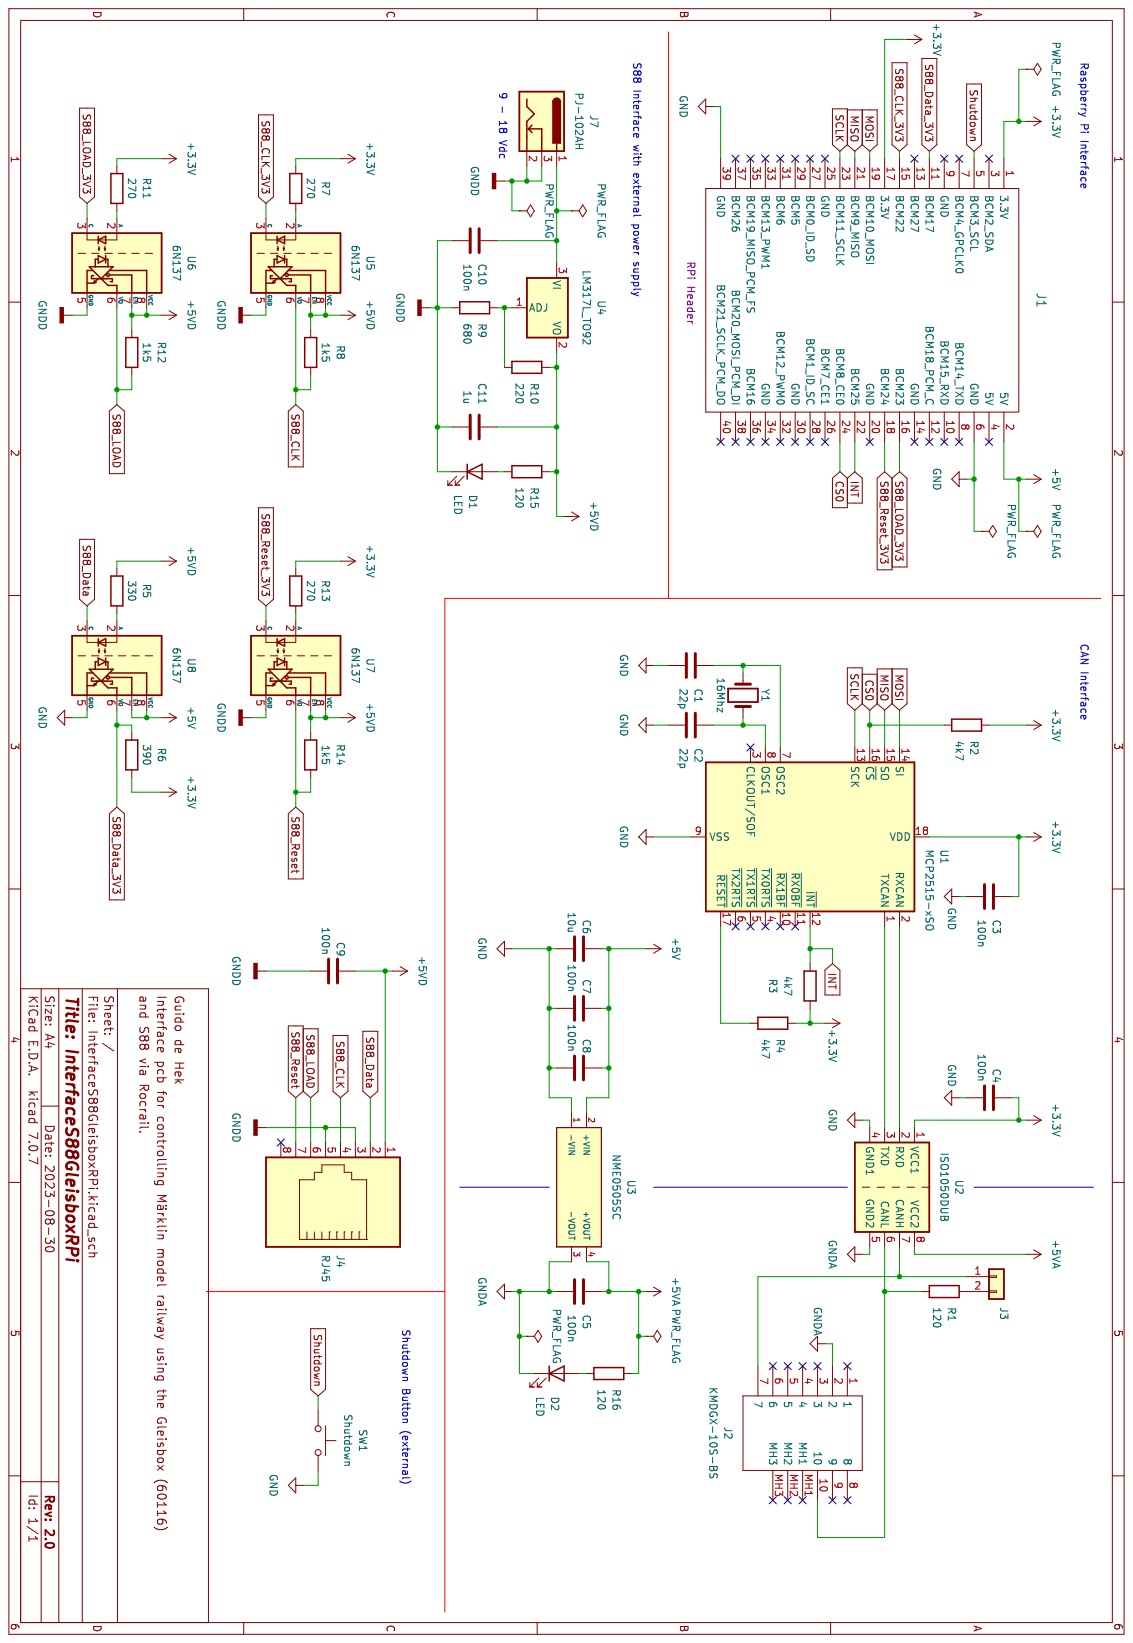
[picture p57: page 1]
