guidodehek/InterfaceS88GleisboxRPi/pcb/InterfaceS88GleisboxRPi/InterfaceS88GleisboxRPi.kicad_pcb

## KiCad design pcb/InterfaceS88GleisboxRPi/InterfaceS88GleisboxRPi.kicad_pcb (2024-05-11)

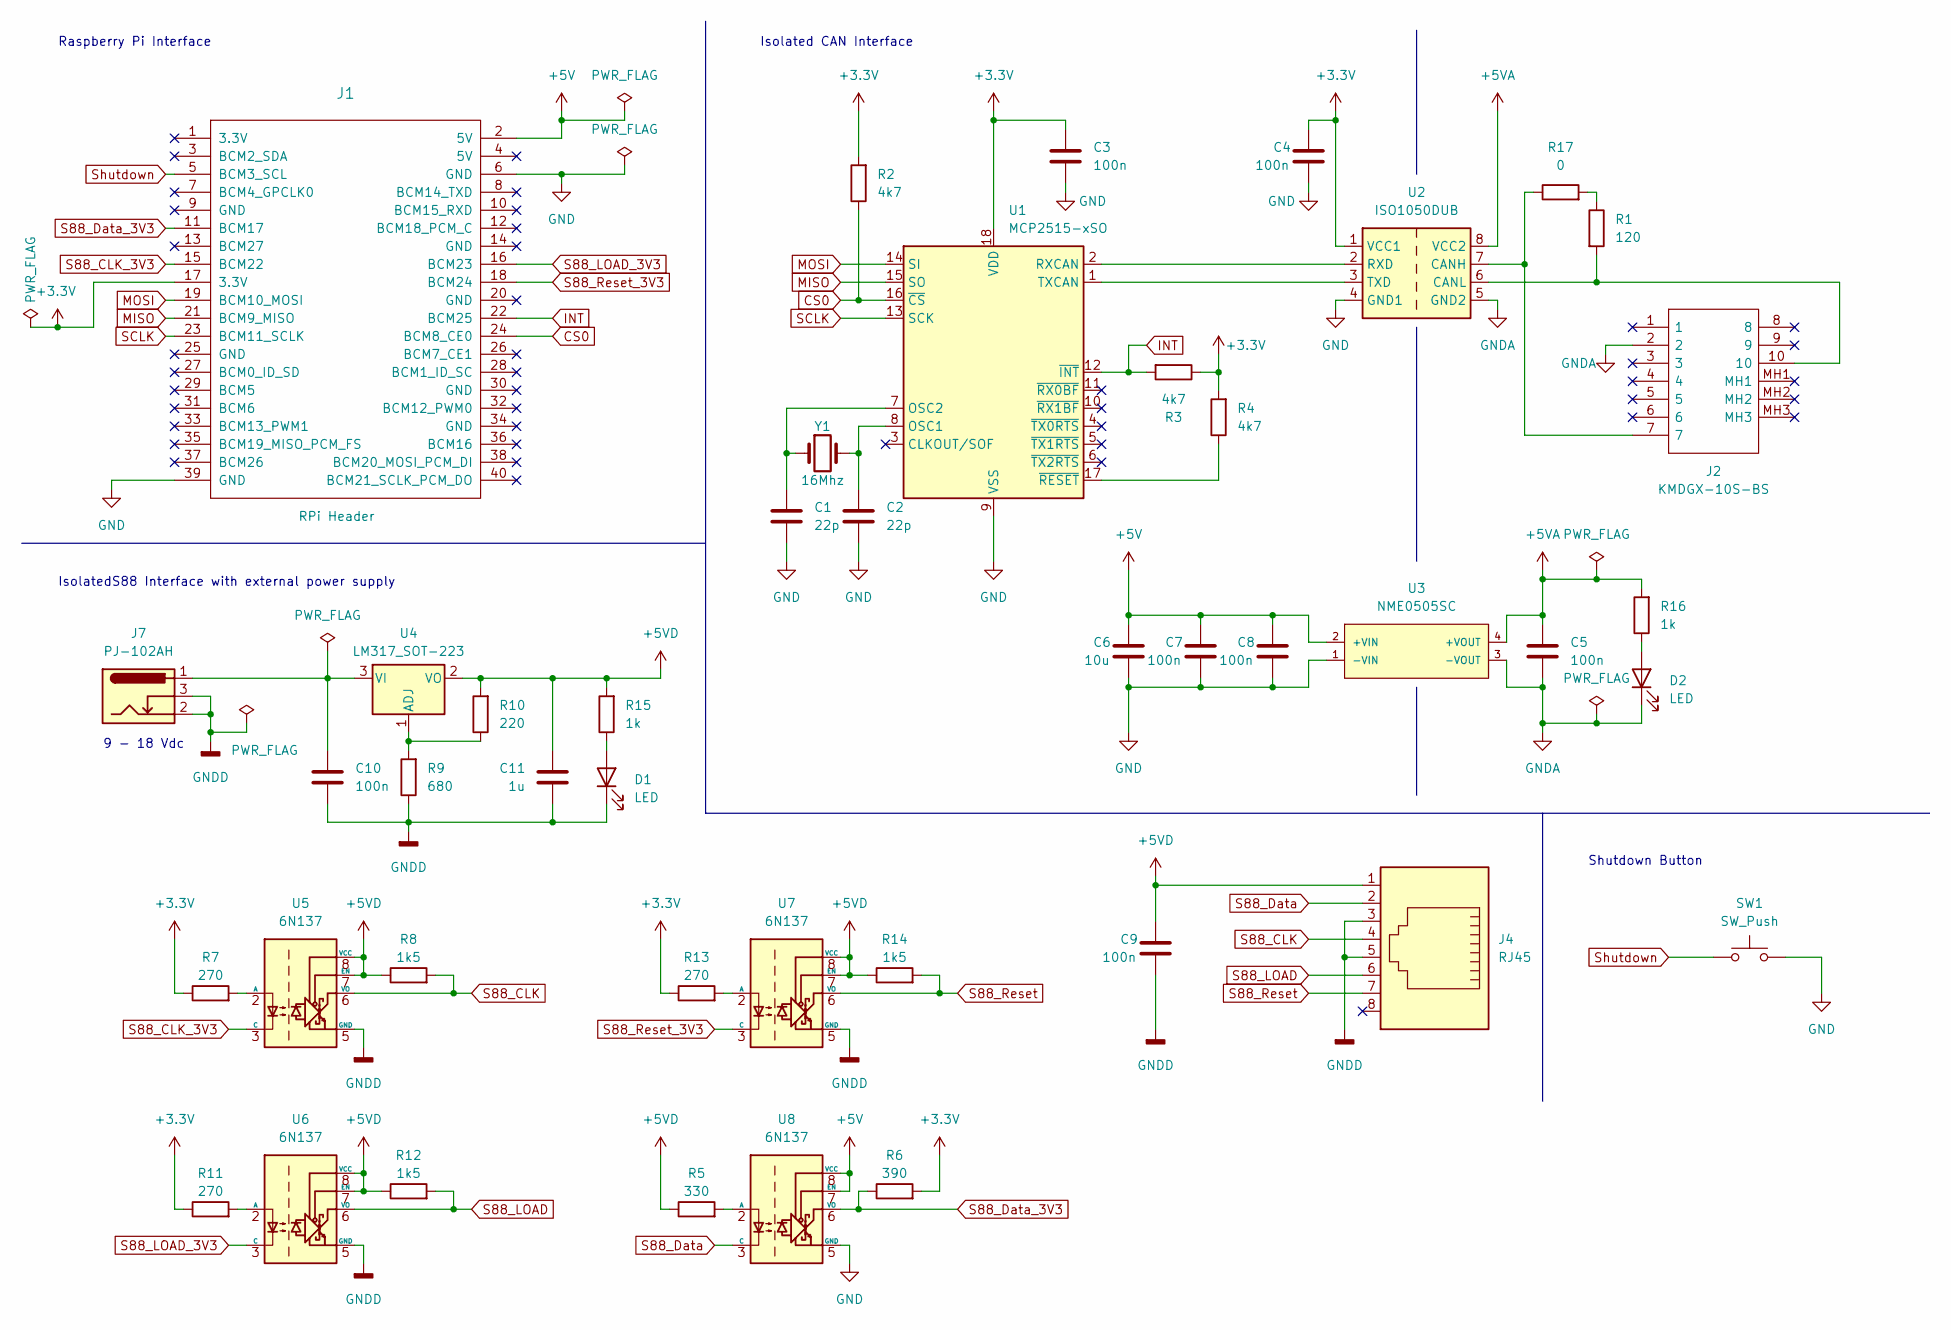
[picture p58: schematic InterfaceS88GleisboxRPi.kicad_sch]

Parts:
C1, C2: 22p; C_0805_2012Metric
C3, C4, C5, C7, C8, C9, C10: 100n; C_0805_2012Metric
C6: 10u; C_0805_2012Metric
C11: 1u; C_0805_2012Metric
D1, D2: LED; LED_0603_1608Metric
J1: PinSocket_2x20_P2.54mm_Vertical
J2: KMDGX-10S-BS; KMDGX10SBS; Mouser Part Number 806-KMDGX-10S-BS
J4: RJ45; 215877-1
J7: PJ-102AH; BarrelJack_CUI_PJ-102AH_Horizontal
R1: 120; R_0805_2012Metric
R2, R3, R4: 4k7; R_0805_2012Metric
R5: 330; R_0805_2012Metric
R6: 390; R_0805_2012Metric
R7, R11, R13: 270; R_0805_2012Metric
R8, R12, R14: 1k5; R_0805_2012Metric
R9: 680; R_0805_2012Metric
R10: 220; R_0805_2012Metric
R15, R16: 1k; R_0805_2012Metric
R17: 0; R_0805_2012Metric
SW1: SW_Push; SW_PUSH_6mm
U1: MCP2515-xSO; SOIC-18W_7.5x11.6mm_P1.27mm
U2: ISO1050DUB; SOP-8_6.62x9.15mm_P2.54mm
U3: NME0505SC; Murata-NME0505SC-0-0-0; output voltage 5V; mouser part number 580-NME0505SC; digikey description CONV DC/DC 1W 5VIN 5VOUT SIP SGL
U4: LM317_SOT-223; SOT-223-3_TabPin2
U5, U6, U7, U8: 6N137; DIP-8_W7.62mm
Y1: 16Mhz; Crystal_HC50_Vertical

Connections:
+3.3V: C3.1, C4.1, J1.17 (3.3V), R2.2, R3.1, R4.2, R6.2, R7.1, R11.1, R13.1, U1.18 (VDD), U2.1 (VCC1)
+5V: C6.1, C7.1, C8.1, J1.2 (5V), U3.2 (+VIN), U8.7 (EN), U8.8 (VCC)
+5VA: C5.1, R16.2, U2.8 (VCC2), U3.4 (+VOUT)
+5VD: C9.1, C11.1, J4.1, R5.1, R8.1, R10.2, R12.1, R14.1, R15.2, U4.2 (VO), U5.7 (EN), U5.8 (VCC), U6.7 (EN), U6.8 (VCC), U7.7 (EN), U7.8 (VCC)
CS0: J1.24 (BCM8_CE0), R2.1, U1.16 (~CS)
GND: C1.2, C2.2, C3.2, C4.2, C6.2, C7.2, C8.2, J1.6 (GND), J1.39 (GND), SW1.2, U1.9 (VSS), U2.4 (GND1), U3.1 (-VIN), U8.5 (GND)
GNDA: C5.2, D2.1 (K), J2.2, U2.5 (GND2), U3.3 (-VOUT)
GNDD: C9.2, C10.2, C11.2, D1.1 (K), J4.3, J4.5, J7.2, J7.3, R9.1, U5.5 (GND), U6.5 (GND), U7.5 (GND)
INT: J1.22 (BCM25), R3.2, U1.12 (~INT)
MISO: J1.21 (BCM9_MISO), U1.15 (SO)
MOSI: J1.19 (BCM10_MOSI), U1.14 (SI)
unnamed: D1.2 (A), R15.1
unnamed: D2.2 (A), R16.1
unnamed: R1.1, R17.2
unnamed: C2.1, U1.8 (OSC1), Y1.2
unnamed: C1.1, U1.7 (OSC2), Y1.1
unnamed: U1.2 (RXCAN), U2.2 (RXD)
unnamed: U1.1 (TXCAN), U2.3 (TXD)
unnamed: R4.1, U1.17 (~RESET)
unnamed: J2.7, R17.1, U2.7 (CANH)
unnamed: J2.10, R1.2, U2.6 (CANL)
unnamed: R9.2, R10.1, U4.1 (ADJ)
unnamed: C10.1, J7.1, U4.3 (VI)
unnamed: R7.2, U5.2 (A)
unnamed: R11.2, U6.2 (A)
unnamed: R13.2, U7.2 (A)
unnamed: R5.2, U8.2 (A)
S88_CLK: J4.4, R8.2, U5.6 (VO)
S88_CLK_3V3: J1.15 (BCM22), U5.3 (C)
S88_Data: J4.2, U8.3 (C)
S88_Data_3V3: J1.11 (BCM17), R6.1, U8.6 (VO)
S88_LOAD: J4.6, R12.2, U6.6 (VO)
S88_LOAD_3V3: J1.16 (BCM23), U6.3 (C)
S88_Reset: J4.7, R14.2, U7.6 (VO)
S88_Reset_3V3: J1.18 (BCM24), U7.3 (C)
SCLK: J1.23 (BCM11_SCLK), U1.13 (SCK)
Shutdown: J1.5 (BCM3_SCL), SW1.1

Notes on the sheet:
9 - 18 Vdc
IsolatedS88 Interface with external power supply
Isolated CAN Interface
Shutdown Button
Raspberry Pi Interface

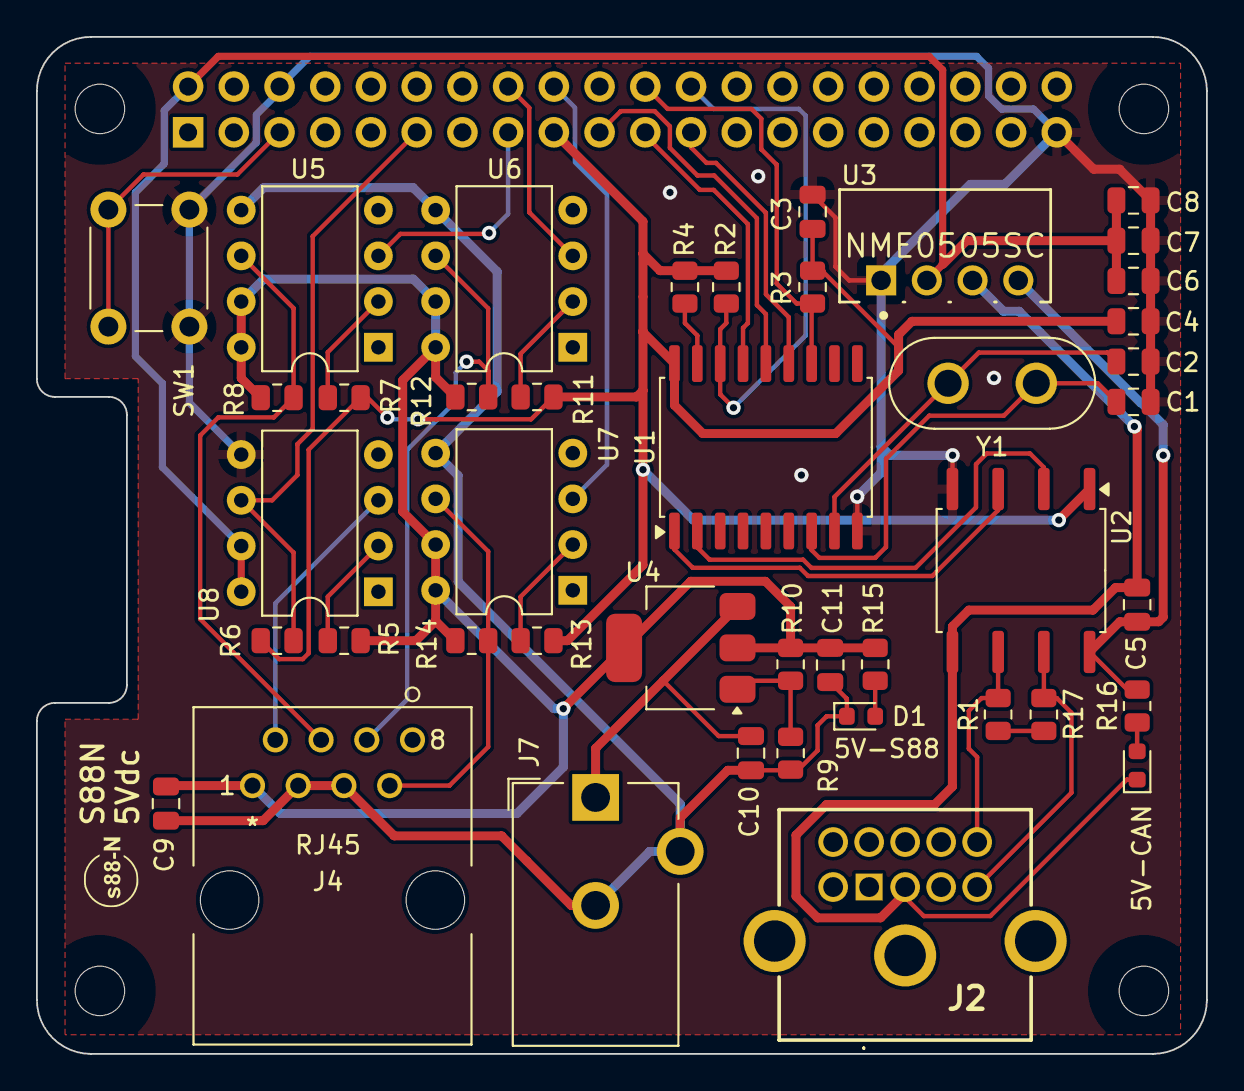
[picture p59: board InterfaceS88GleisboxRPi.kicad_pcb from above]

Board: 2 copper layers, 65.0 x 56.5 mm, 46 parts (1 on the bottom side), 37 nets.

Other parts of the board:
H1, H2: RPi_Hat_Mounting_Hole
