guidodehek/InterfaceS88GleisboxRPi/(commit log)

2023-01-06 feat: add documentation
    feat: add kicad project based on RPi_Hat template
    [InterfaceS88GleisboxRPi.kicad_pcb, InterfaceS88GleisboxRPi.kicad_sch]
2023-01-06 wip: initial schematic design
    [EDI2CAP.CFG, InterfaceS88GleisboxRPi.kicad_pcb, InterfaceS88GleisboxRPi.kicad_sch, Murata_-_NME0505SC.step, SS-90000-011.SchLib, SS-90000-011.stp, SS90000011.PcbLib, chips.prt]
2023-01-06 wip: initial schematic design / layout
    [EDI2CAP.CFG, InterfaceS88GleisboxRPi.kicad_pcb, InterfaceS88GleisboxRPi.kicad_sch, SS-90000-011.SchLib, SS-90000-011.stp, SS90000011.PcbLib, chips.prt, ss90000011.psm]
2023-01-06 wip: layout
    [InterfaceS88GleisboxRPi.kicad_pcb, InterfaceS88GleisboxRPi.kicad_sch]
2023-01-07 feat: perform drc
    [InterfaceS88GleisboxRPi.kicad_pcb, InterfaceS88GleisboxRPi.kicad_sch]
2023-01-11 feat: s88 circuit how has galvanic isolation and an external power input
    [InterfaceS88GleisboxRPi.kicad_pcb, InterfaceS88GleisboxRPi.kicad_sch]
2023-01-13 feat: use rj45 connector for s88
    fix: solve routing errors
    [InterfaceS88GleisboxRPi.kicad_pcb, InterfaceS88GleisboxRPi.kicad_sch]
2023-01-13 fix: solve routing warnings
    [InterfaceS88GleisboxRPi.kicad_pcb]
2023-01-13 feat: change labels
    [InterfaceS88GleisboxRPi.kicad_pcb, InterfaceS88GleisboxRPi.kicad_sch]
2023-01-13 feat: generate gerbers and drill files
    [InterfaceS88GleisboxRPi-B_Cu.gbl, InterfaceS88GleisboxRPi-B_Cu.gbr, InterfaceS88GleisboxRPi-B_Mask.gbs, InterfaceS88GleisboxRPi-B_Paste.gbp, InterfaceS88GleisboxRPi-B_Silkscreen.gbo, InterfaceS88GleisboxRPi-B_Silkscreen.gbr, InterfaceS88GleisboxRPi-Edge_Cuts.gm1, InterfaceS88GleisboxRPi-F_Cu.gbr]
2023-01-26 feat: generate BOM
    [InterfaceS88GleisboxRPi_BOM.xlsx]
2023-02-22 bugfix: switched CAN-high and CAN-low connection to mini-din connector
    [InterfaceS88GleisboxRPi.kicad_pcb, InterfaceS88GleisboxRPi.kicad_sch]
2023-08-30 fix: issue with S88N pinning
    [InterfaceS88GleisboxRPi.kicad_pcb, InterfaceS88GleisboxRPi.kicad_sch]
2023-08-30 feat: instructions for using s88usp-rpi (gbert)
    [InterfaceS88GleisboxRPi.kicad_pcb]
2023-08-31 fix: U8 must use rpi ground (GND) instead of GNDD on pin 5
    [InterfaceS88GleisboxRPi.kicad_pcb, InterfaceS88GleisboxRPi.kicad_sch]
2023-08-31 feat: add power status leds
    feat: increase track width of power lines
    feat: reroute for new power connector
    [InterfaceS88GleisboxRPi.kicad_pcb, InterfaceS88GleisboxRPi.kicad_sch]
2023-08-31 feat: simplify routing
    [InterfaceS88GleisboxRPi.kicad_pcb]
2023-08-31 feat: add reverse polarity schottky diode
    [InterfaceS88GleisboxRPi.kicad_pcb, InterfaceS88GleisboxRPi.kicad_sch]
2023-08-31 feat: add S88n logo
    [InterfaceS88GleisboxRPi.kicad_pcb]
2023-11-04 fix: pcb sheet text
    fix: minor routing changes
    wip: manual for rpi preparation
    [InterfaceS88GleisboxRPi.kicad_pcb, InterfaceS88GleisboxRPi.kicad_sch]
2023-11-05 Update raspberrypisetup.tex
    use 32 bit PiOS
2023-12-06 fix: minor layout changes
    fix: minor manual changes
    [InterfaceS88GleisboxRPi.kicad_pcb]
2024-03-18 fix: minor routing improvements
    [InterfaceS88GleisboxRPi.kicad_pcb, InterfaceS88GleisboxRPi.kicad_sch]
2024-03-18 feat: upgrade to kicad 8
    [InterfaceS88GleisboxRPi.kicad_pcb, InterfaceS88GleisboxRPi.kicad_sch]
2024-05-10 feat: s88 supply is smd
    feat: shuffle components
    [InterfaceS88GleisboxRPi.kicad_pcb, InterfaceS88GleisboxRPi.kicad_sch]
2024-05-10 feat: shutdown button
    feat: rotate 6N137 ICs
    [InterfaceS88GleisboxRPi-B_Cu.gbl, InterfaceS88GleisboxRPi-B_Cu.gbr, InterfaceS88GleisboxRPi-B_Mask.gbs, InterfaceS88GleisboxRPi-B_Paste.gbp, InterfaceS88GleisboxRPi-B_Silkscreen.gbo, InterfaceS88GleisboxRPi-B_Silkscreen.gbr, InterfaceS88GleisboxRPi-Edge_Cuts.gm1, InterfaceS88GleisboxRPi-F_Cu.gbr]
2024-05-11 fix: pads for 5Vdc supply are fixed
    [InterfaceS88GleisboxRPi.kicad_pcb]
2024-07-20 wip: save
    [BillOfMaterials.xlsx, InterfaceS88GleisboxRPi_BOM.xlsx]
